AMSAT-NA/PacSatDocs/Test_Data/1_2_V_supply_voltage_noise_and_shift_with_modulation.jpg

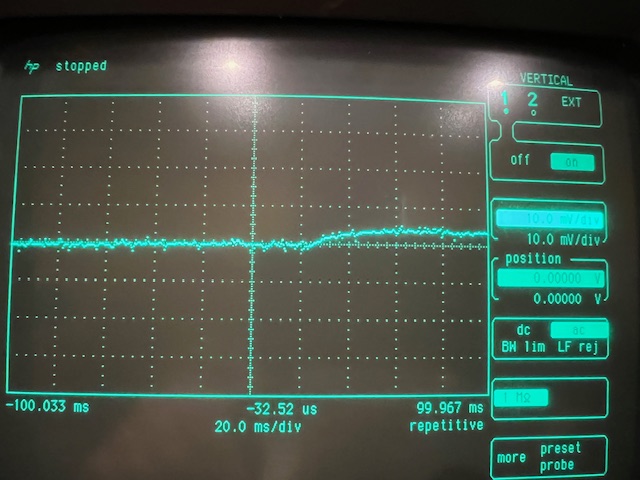
Test_Data/1_2_V_supply_voltage_noise_and_shift_with_modulation.jpg
