AMSAT-NA/PacSatDocs/Test_Data/Port_4_N_with_neg87dB_signal_input.jpg

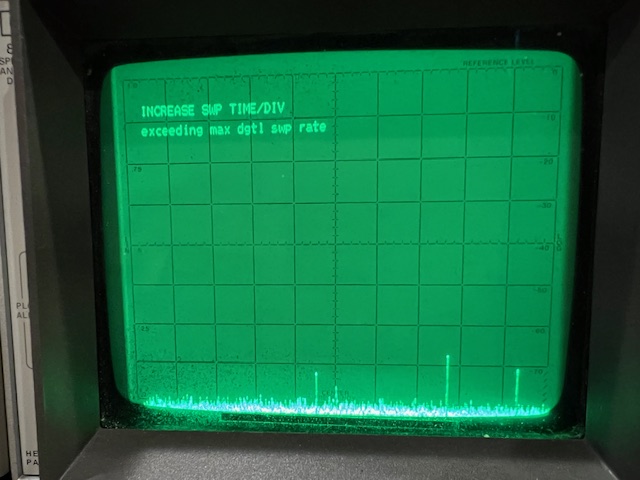
Test_Data/Port_4_N_with_neg87dB_signal_input.jpg
