AMSAT-NA/PacSatDocs/Hardware/Rev_D/PacSat_Dev_RevD_240614/gerbers/README

This directory contains the fabrication outputs necessary 
to get the board etched at a PCB house.
