AMSAT-NA/PacSatDocs/requirements/Pacsat-rtos-software-architecture.odp

PACSAT RTOS Software Architecture

By: Chris Thompson G0KLA, Burns Fisher WB1FJ

Version: 1.02 – 14 Jun 2023

RX Task

Read FIFO data and write PKT to queue

RX PKT Queue

TX Task

For each PKT in queue send preamble and packet

PB PKT Queue

AX25 Task

4x Data Link State Machine

PB Task

PB State Machine

Command

Decode software and hardware commands

Console Task

User interaction for testing

TX PKT Queue

Uplink Task

4x FTL0 State Machines

Telem & Control Task

Periodically collect telemetry and assemble packets

2

RX Event Queue

I-Frame Queue[4]

Reliance Edge File System

Key

AX5043 “FIFO not empty”

AX5043 “FIFO not empty”

BBS

callsign

Uplink Event Queue

2

Data

RTOS Event

AX5043 “FIFO not empty”

AX5043 “FIFO not empty”

4

2

FTL0

Status

RTOS Priority

RTOS Timer

T1 x4

T3 x4

2

Broadcast

callsign

PB

Status

Experiment & Telemetry Data

(WOD)

Experiments

Telemetry Sensors

2

AX5043 “Ready to send”

I2C

SPI

CAN

3

MET Telem Timer


S

2

2
