AMSAT-NA/PacSatDocs/Demo/Pacsat-demo-script-2023-symposium.odt

Symposium demonstration

Setup

The spacecraft is connected to a battery, it has a real time clock. It is powered down.

There are 5 files pre-loaded:

1. WOD file – as though generated on the spacecraft
2. Experiment file 1 – uploaded as though from another spacecraft
3. Experiment file 2 – as though generated on the spacecraft
4. Bulletin message to ALL showing the AMSAT bulletin
5. Message to another station with an image

Before the demo:

- There is sufficient space to upload another short file
- The files are uploaded so that they will not expire on the day of the presentation
- The PB is Open
- The Uplink is Open
- The time is set
- The ground station is open and listening. It contains no directory and has one draft file to upload.
- Dir age should be 99 to make sure we pick up the files.
- No equations – remove any that exist

Demo Procedure

Intro

- Re-cover the purpose of the satellite. A data store designed for delay tolerant connections and able to support on board or uploaded data
- Set the scene by describing a typical ground station and the current state – a satellite with pre-loaded files – WOD telemetry, experiment data, Uploaded from a distant sat, messages from Amateur stations uploaded from the ground.
- Explain why we have a copy of the ground station and how operation differs to a BBS with online connection

Action: The power is connected to the spacecraft and it “comes over the horizon”:

- The PB is seen and the DIR is requested
- Describe the dir contents
- The telemetry is received and should be described box by box on the telemetry tab
- Note the free space is for a small amount of test RAM on the MRAM Disk
- Note the number of files vs what we see in the directory

Action: Download the AMSAT bulletin by setting it P1

- File is received

Action: Setup equation to download PARTNER1 data

- File is received
- Note that we can export the data
- Note that all received packets are sent to the central server so that stations can collaboratively download large files which are re-assembled there and can be shared with experiment partners

Action: Note that data can be sent from other spacecraft but can also be sent by Hams for fun. Reply to the AMSAT bulletin with a comment

- File is uploaded

Action: Press DIR button to refresh the directory

- Uploaded File is visible in dir

Action: Download the image file

- Note that this could be experiment data from an onboard camera or it could be data from another spacecraft. It can also be an image uploaded by a ham for fun
- While downloading explain that we plan future tests at higher speeds, with different formats and automated between two satellites working together.

TO RESET THE TEST

To make resetting the test easier a copy of the ground station contains the files to be uploaded and the callsign of the uploader

- Open the PACSAT_DEMO_SETUP version of the ground station
- Send the Format command to the spacecraft
- Send the Time command to the spacecraft
- Open each of the 5 files in the Outbox and click Send
- When they are uploaded close the PACSAT_DEMO_SETUP version
- Go into PACSAT_DEMO folder and delete the Pacsat dir contents.
- Unplug the spacecraft.
- Open the PACSAT_DEMO version of the spacecraft
- The Demo is ready to run
