AMSAT-NA/PacSatDocs/Hardware/pinouts.ods

Connector Pins Used on PacSat-Dev Board vs. LTM Document
N5BRG 7/13/23
LTM Document |  |  | CubeSpace ADCS |  | PacSat_Dev
Yellow | 1 |  | CANL | 1 | 3.3V
H1 | 2 |  |  | 2
 | 3 |  | CANH | 3
 | 4 |  |  | 4
 | 5 |  |  | 5
 | 6 |  |  | 6
 | 7 |  |  | 7
 | 8 |  |  | 8
 | 9 |  |  | 9 | 3.3V
 | 10 |  |  | 10
 | 11 |  |  | 11
 | 12 |  |  | 12
 | 13 |  |  | 13
 | 14 |  |  | 14 | GIOA_3
 | 15 |  |  | 15 | GIOA_2
 | 16 |  |  | 16 | GIOA_1
 | 17 |  | UART1 | 17 | GIOA_6
 | 18 |  | UART1 | 18
 | 19 |  | UART1 | 19 | FAULT_N
 | 20 | TLM4 | UART1 | 20
 | 21 | TLM3 |  | 21
 | 22 | TLM2 |  | 22
 | 23 | TLM1 |  | 23 | HW_POWER_OFF_N
 | 24 |  |  | 24
 | 25 |  |  | 25
 | 26 |  |  | 26
 | 27 | L1 |  | 27 | CMD_MODE
 | 28 |  |  | 28
 | 29 | I2C1_reset |  | 29
 | 30 |  |  | 30
 | 31 |  |  | 31 | ATTACHED
 | 32 |  |  | 32 | UART_TX2
 | 33 |  | UART2 | 33
 | 34 |  |  | 34
 | 35 |  | UART2 | 35 | VER_BIT1
 | 36 |  |  | 36 | UART_RX2
 | 37 |  |  | 37
 | 38 |  |  | 38
 | 39 | Tx3 | UART2 | 39
 | 40 | Rx3 | UART2 | 40
 | 41 | I2C1_sda | I2c_SDA | 41 | I2C1_sda
 | 42 |  |  | 42
 | 43 | I2C_sck | I2c_SCK | 43 | I2C_sck
 | 44 |  |  | 44
 | 45 |  |  | 45
 | 46 |  |  | 46
 | 47 |  | Sw 5V Options | 47 | VER_BIT0
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
