AMSAT-NA/PacSatDocs/requirements/LaunchPad_Headers.ods

 |  |  |  |  | The common term for the data lines is MISO and MOSI. |  |  | Note: Device highlighted must be selected in Pinmux
 |  |  |  | TI calls them SOMI and SIMO, the MRAMs call them SO and SI.
 |  |  |  | SOC Device 1 | SOC Device 2 | SOC Device 3 | SOC Device 4 | WB1BF Propsed Use | Programming comments | Board Symbols
 |  | J2
 |  |  | 1 | +3.3V |  |  |  | Power |  | +3.3V
 |  |  | 2 | AD1IN[16]/AD2IN[0] | AD2IN[0]
 |  |  | 3 | N2HET1[6] | SCIRX | EPWM5A |  | Console serial line (Rx) |  | SCIRX
 |  |  | 4 | N2HET1[13] | SCITX | EPWM5B |  | Console serial line (Tx) |  | SCITX
 |  |  | 5 | GIOA[7] | N2HET2[6] | EPWM2A
 |  |  | 6 | AD1IN[17] | AD2IN[1]
J11 | 38 |  | 7 | MIBSPI3CLK | AWM_EXT_SEL[1] | EQEP1A |  | CLK For AX5043 chips |  | AX5043_CLK
 |  |  | 8 | GIOA[6] | N2HET2[4] | EPWM1B
 |  |  | 9 | N2HET1[4] | EPWM4B
 |  |  | 10 | N2HET1[9] | N2HET2[16] | EPWM7A
 |  | J3
 |  |  | 1 | +5V In with JP3 |  |  |  |  |  | +5V
 |  |  | 2 | GND |  |  |  | Ground |  | Ground
 |  |  | 3 | AD1N[0]
 |  |  | 4 | AD1N[7]
 |  |  | 5 | AD1N[18] | AD1N[2]
 |  |  | 6 | AD1N[19] | AD1N[3]
 |  |  | 7 | AD1N[20] | AD1N[4]
 |  |  | 8 | AD1N[21] | AD1N[5]
 |  |  | 9 | Unused?
 |  |  | 10 | Unused?
 |  | J4
 |  |  | 1 | N2HET1[20] | /EPWM6B
 |  |  | 2 | N2HET1[18] | EPWM6A
 |  |  | 3 | N2HET1[16]
 |  |  | 4 | N2HET1[30] | MII_RX_DV | EPWM1SYNCI | EQEP2S
 |  |  | 5 | N2HET1[14]
 |  |  | 6 | N2HET1[12] | MII_CRS | RMII_CRS_DV
 |  |  | 7 | GIOA[5] | EXTCLKIN | EPWM1A
 |  |  | 8 | GIOA[2] | N2HET2[0] | EQEP2I
 |  |  | 9 | GIOA[1]
 |  |  | 10 | GIOA[0]
 |  | J5
 |  |  | 1 | GND
 |  |  | 2 | N2HET1[22]
J11 | 30 |  | 3 | MIBSPI3NCS[1] | N2HET1[25] | MDCLK |  | Chip select for AX5043_0 |  | AX5043_VHF_SEL
 |  |  | 4 | GIOB[3] |  |  |  | IRQ for AX5043-1 |  | AX5043_UHF_IRQ
 |  |  | 5 | HERCULES_NRST
J11 | 37 |  | 6 | MIBSPI3SIMO | AWM_EXT_SEL[0] | ECAP3 |  | MOSI for AX5043s |  | AX5043_MOSI
J11 | 36 |  | 7 | MIBSPI3SOMI | AWM_EXT_ENA | ECAP2 |  | MISO for AX5043s |  | AX5043_MISO
 | 9 |  | 8 | MIBSPI3NCS[2] | I2C_SDA | N2HET1[27] | NTZ2 | I2C SDA (if you want a temp chip like the Pi 5043 card has) |  | I2C_SDA
 | 8 |  | 9 | MIBSPI3NCS[3] | I2C_SCL | N2HET1[29] | NTZ1 | I2C SCL (if you want a temp chip like the Pi 5043 card has) |  | I2C_SCL
 |  |  | 10 | GIOB[2]
 |  | J6
 |  |  | 1 | +3.3 V |  |  |  | Power |  | NP
 |  |  | 2 | AD1IN[9] | AD2IN[9]
 |  |  | 3 | HERCULES_LIN1_RXD
 |  |  | 4 | HERCULES_LIN1_TXD
 |  |  | 5 | MIBSPI3NCS[0] | AD2EVT | GIOB[2] | EQEP1I
 |  |  | 6 | AD1IN[1]
J10 | 32 |  | 7 | MIBSPI1CLK |  |  |  | MRAM CLK |  | MRAM_SCK
 |  |  | 8 | MIBSPI3NENA | MIBSPI3NCS[5] | N2HET1[31] | EQEP1B
J10 | 37 |  | 9 | N2HET1[24] | MIBSPI1NCS[5] | MII_RXD[0] | RMII_RXD[0] | MRAM-3 NCS |  | MRAM_3_CS
 |  |  | 10 | N2HET1[26] | MII_RXD[1] | RMII_RXD[1]
 |  | J7
 |  |  | 1 | +5.0 V |  |  |  |  |  | NP
J10 | 34 |  | 2 | GND |  |  |  | Ground |  | Ground
 |  |  | 3 | AD1IN[10] | AD2IN[10]
 |  |  | 4 | AD1IN[2]
 |  |  | 5 | AD1IN[3]
 |  |  | 6 | AD1IN[11] | AD2IN[11]
 |  |  | 7 | AD1IN[4]
 |  |  | 8 | AD1IN[12] | AD2IN[12]
 |  | J8
 |  |  | 1 | N2HET1[10] | MII_TX_CLK | MII_TX_AVCLK4 | NTZ3
 |  |  | 2 | N2HET1[28] | MII_RXCLK | RMII_REFCLK | MII_RX_AVCLK4
 |  |  | 3 | N2HET1[8] | MIBSPI1SIMO[1] | MII_TXD[3]
 |  |  | 4 | MIBSPI1NENA | N2HET1[23] | MII_RXD[2] | ECAP4
 |  |  | 5 | MIBSPI5NENA | MII_RXD[3] | MIBSPI5SOMI[1] | ECAP5
J11 | 11 |  | 6 | N2HET1[11] | MIBSPI3NCS[4] | N2HET2[18] | EPWM1SYNCO | AX5043-1 NCS |  | AX5043_UHF_CS
 |  |  | 7 | GIOB[1]
J10 | 15 |  | 8 | GIOB[0] |  |  |  | AX5043-0 IRQ | Set up interrupt in GIO and Interrupt Tabs | AX5043_VHF_IRQ
 |  |  | 9 | AD1EVT | MII_RX_ER | RMII_RX_ER
 |  |  | 10 | MIBSPI5CLK | MII_TXEN | RMII_TXEN
 |  | J9
 |  |  | 1 | GND
 |  |  | 2 | N2HET1[1] | SPI4NENA | N2HET2[8] | EQEP2A
J10 | 26 |  | 3 | MIBSPI1NCS[0] | MIBSPI1SOMI[1] | MII_TXD[2] | ECAP6 | MRAM-0 NCS |  | MRAM_0_CS
 |  |  | 4 | MIBSPI5SIMO[0] | MII_TXD[1] | RMII_TXD[1] | MIBSPI5SOMI[2]
 |  |  | 5 | HERCULES_NRST
J10 | 35 |  | 6 | MIBSPI1SIMO |  |  |  | MRAM SI |  | MRAM_MOSI
J10 | 33 |  | 7 | MIBSPI1SOMI |  |  |  | MRAM SO |  | MRAM_MISO
J10 | 11 |  | 8 | MIBSPI1NCS[1] | N2HET1[17] | MII_COL | EQEP1S | MRAM-1 NCS |  | MRAM_1_CS
J11 | 31 |  | 9 | MIBSPI1NCS[2] | N2HET1[19] | MDIO |  | MRAM-2 NCS |  | MRAM_2_CS
 |  |  | 10 | MIBSPI5SOMI[0] | MII_TXD[0] | RMII_TXD[0]
