AMSAT-NA/PacSatDocs/Hardware/Rev_D/PacSat_Dev_RevD_240614/PacSat_CPU_Pin_Assignment.ods

Sheet: ROOT LIST CPU Pin
Last Revised | 231117 | RSS
CPU Pin # | Discription | Signal | Connection |  | Pin Use | Voltage | Pullup/Down
1 | GIOB_3 | GIOB_3 | PC104-14 | IO | Bidirectional | ?
2 | GIOA_0 | FCODE_STROBE | PC104-56 | IO | Bidirectional | ?
3 | MIBSPI3NCS_3 | I2C_SCL | U30-2 | Temp Susnor | Output | 3.3V
4 | MIBSPI3NCS_2 | I2C_SDA | U30-1 | Temp Sensor | Bidirectional | 3.3V
5 | GIOA_1 | AX5043_IRQ_RX1 | U205-19 | RX1_IRQ | Input | 3.3V | Add on chip pullup
6 | N2HET_11 | HW_Sense | Pull Up | Not USED | Input | ?
7 | FLTP1 | No Connection |  |  | Not USED
8 | FLTP2 | No Connection |  |  | Not USED
9 | GIOA_2 | GIOA_2 | PC104-14 | IO | Bidirectional | ?
10 | VCCIO | +3.3VDC |  |  | PWR | 3.3V
11 | VSS | GND Plane |  |  | GND
12 | CAN3RX | No Connection |  |  | Not USED
13 | CAN3TX | HW_POWER_OFF_N | PC104-23 | IO | Input | ?
14 | GIOA_5 | AX5043_IRQ_RX4 | U505-19 | RX4_IRQ | Input | ? | Add on chip pullup
15 | N2HET1_22 | ALERT_SIGNAL | PC104-49 | IO | Input | ?
16 | GIOA_6 | GIOA_6 | PC104-17 | IO | Bidirectional | ?
17 | VCC | +1.2 VDC |  |  | PWR | 1.2V
18 | OSCN | Clock5 |  |  | CLK | 3.3V
19 | Kelvin GNS | GND Plane |  |  | GND
20 | OSCOUT | No Connection |  |  | No Connection
21 | VSS | GND Plane |  |  | GND
22 | GIOA_7 | AX5043_IRQ_RX3 | U405-19 | RX3_IRQ | Input | 3.3V | Add on chip pullup
23 | N2HET1_1 | LED D3 YEL | D3-1 |  | Output | 3.3V
24 | N2HET1_3 | AX5043_SEL1 | U205-14 | RX1_SEL | Output | 3.3V
25 | N2HET1_0 | LED D2 RED | D2-1 | LED RED | Output | 3.3V
26 | VCCIO | +3.3 VDC |  |  | PWR | 3.3V
27 | VSS | GND Plane |  |  | GND
28 | VSS | GND Plane |  |  | GND
29 | VCC | +1.2 VDC |  |  | PWR | 1.2V
30 | N2HET1_2 | LED D4 GRN | D4-1 | LED-GRN | Output | 3.3V
31 | N2HET1_5 | REG_5V_EN | U86-2 | +5V Enable | Output | 3.3V
32 | MIBSPI5NCS_0 | MRAM_NCS3 | U79-1 |  | Output | 3.3V
33 | N2HET1_7 | AX5043_SEL2 | U305-1 | RX2 Select | Output | 3.3V
34 | TEST | GND Plane |  |  | GND
35 | N2HET1_9 | AX5043_SEL3 | U405-14 | RX3 SEL | Output | 3.3V
36 | N2HET1_4 | AX5042_SEL4 | U505-14 | RX4 SEL | Output | 3.3V
37 | MIBSP13NCS_1 | No Connection |  |  | No Connection
38 | N2HET1_6/SCIRX | UART_RX1 | PC104-92 | USB RX | Input | 3.3V
39 | N2HET1_13/SCITX | UART_TX1 | PC104-88 | USB TX | Output | 3.3V
40 | MIBSPI1NCS_2 | MRAM_NCS2 | U77-1 | MRAM CS | Output | 3.3V
41 | N2HET1_15 | FCODE_D0 | PC104-64 |  | Input | ?
42 | VCCIO | +3.3 VDC |  |  | PWR | 3.3V
43 | VSS | GND Plane |  |  | GND
44 | VSS | GND Plane |  |  | GND
45 | VCC | +1.2VDC |  |  | PWR | 1.2V
46 | nPORRST | Pull Up 3.3K Ohm |  |  | Input | 3.3V
47 | VSS | GND Plane |  |  | GND
48 | VCC | +1.2VDC |  |  | PWR | 1.2V
49 | VCC | +1.2VDC |  |  | PWR | 1.2V
50 | VSS | GND Plane |  |  | GND
51 | MIBSPI3SOMI | AX5043_MISO | U205-16,U156-16,U405-16,J801-6,U505-16 | AX5043 MISO | Input | 3.3V
52 | MIBSPI3SOMO | AX5043_MOSI | U205-17,U156-17,U405-17,J801-4,U505-17 | AX5043 MOSI | Output | 3.3V
53 | MIBSPI3CLK | AX5043_CLK | U205-15,U156-15,U405-15,J801-8,U505-15 | AX5043 CLK | CLK | 3.3V
54 | MIBSPI3NENA | No Connection |  |  | No Connection
55 | MIBSPI3NCS_0 | MRAM_NCS1 | U78-1 | MRAM CS | Output | 3.3V
56 | VSS | GND Plane |  |  | GND
57 | VCC | +1.2VDC |  |  | PWR | 1.2V
58 | AD1IN16 | No Connection |  |  | No Connection
59 | AD1IN17 | No Connection |  |  | No Connection
60 | AD1IN_0 | No Connection |  |  | No Connection
61 | AD1IN_7 | PWR_FLAG_AX5043 | U93-6 | AX5043 3.3V Supply | Input A/D | 3.3V
62 | AD1IN_18 | No Connection |  |  | No Connection
63 | AD1IN_19 | No Connection |  |  | No Connection
64 | AD1IN_20 | VER_BIT0 | Resistor |  | Input | 3.3V
65 | AD1IN_21 | VER_BIT1 | Resistor |  | Input | 3.3V
66 | ADREFHI | +3.3VDC |  |  | PWR | 3.3V
67 | ADREFLO | GND Plane |  |  | GND
68 | VSSAD | GND Plane |  |  | GND
69 | VCCAD | +3.3VDC |  |  | PWR | 3.3V
70 | AD1IN_9 | No Connection |  |  | No Connection
71 | AD1IN_1 | No Connection |  |  | No Connection
72 | AD1IN_10 | No Connection |  |  | No Connection
73 | AD1IN_2 | Current_Fault_U89 | NOT USED? |  | No Connection
74 | AD1IN_3 | Current_Fault_U89 | NOT USED? |  | No Connection
75 | AD1IN_11 | No Connection |  |  | No Connection
76 | AD1IN_4 | PWR_FLAG_SSPA | U94-6 | SSPA | Input | 3.3V
77 | AD1IN_12 | A/D 12 | R119,R117 | +5VDC A/D Inpit | Input A/D | 2.5V
78 | AD1IN_5 | PWR_SW_SSPA | U94-4 | SSPA Enable | Output | 3.3V
79 | AD1IN_13 | A/D 13 | R118 | +1.2VDC A/D Inpit | Input A/D | 1.2V
80 | AD1IN_6 | A/D 6 | R114,R115 | +3.3VDC A/D Inpit | Input A/D | 3.3V
81 | AD1IN_22 | No Connection |  |  | No Connection
82 | AD1IN_14 | VER_BIT2 | Resistor |  | Input | 3.3V
83 | AD1IN_8 | No Connection |  |  | No Connection
84 | AD1IN_23 | No Connection |  |  | No Connection
85 | AD1IN_15 | VER_BIT3 | Resistor |  | Input | 3.3V
86 | AD1EVT | No Connection |  |  | No Connection
87 | VCC | +1.2VDC |  |  | PWR | 1.2V
88 | VSS | GND Plane |  |  | GND
89 | CAN1TX | No Connection |  |  | No Connection
90 | CAN1RX | No Connection |  |  | No Connection
91 | N2HET1_24 | UART_CTS (DTE) | PC104-100 | USB CTS | Input | 3.3V
92 | N2HET1_26 | UART_RTS (DTE) | PC104-96 | USB RTS | Output | 3.3V
93 | MIBSP1SMO | MRAM_MOSI | U76-5 | MRAM SI | Output | 3.3V
94 | MIBSP1SMI | MRAM_MISO | U76-6, U77-6, U78-6, U79 -6 | MRAM SO | Input | 3.3V
95 | MIBSPI1CLK | MRAM_CLK | U76-1, U77-1, U78-1, U79 -1 | MRAM SCK | CLK Output | 3.3V
96 | MIBSP11NENA | No Connection |  |  | No Connection
97 | MIBSP15NENA | No Connection |  |  | No Connection
98 | MIBSP15SOMI_0 | No Connection |  |  | No Connection
99 | MIBSP15SIMO_0 | No Connection |  |  | No Connection
100 | MIBSPI5CLK | No Connection |  |  | No Connection
101 | VCC | +1.2VDC |  |  | PWR | 1.2V
102 | VSS | GND Plane |  |  | GND
103 | VSS | GND Plane |  |  | GND
104 | VCCIO | +3.3VDC |  |  | PWR | 3.3V
105 | MIBSPI1NCS_0 | MRAM_NCS0 | U76-1 | MRAM 0 CS | Output | 3.3V
106 | N2HET1_8 | ATTACHED | PC104-31 |  | Input | ?
107 | N2HET1_28 | PB_ENABLE | PC104-49 |  | Input | ?
108 | TMS | JTAG_TMS | J2-2 |  | Input | 3.3V
109 | nTRST | Pull Up 3.3K Ohm |  |  | Input | 3.3V
110 | TDI | JTAG_TDI | J2-8 |  | Input | 3.3V
111 | TDO | JTAG_TDO | J2-6 |  | Output | 3.3V
112 | TCK | JTAG_TCK | J2-4 |  | Input CLK | 3.3V
113 | RTCK | JTAG_RTCK | J2-7 |  | Input CLK | 3.3V
114 | VCC | +1.2VDC |  |  | PWR | 1.2V
115 | VSS | GND Plane |  |  | GND
116 | nRST | Pull Up 3.3K Ohm |  |  | Input | 3.3V
117 | nERROR | FAULT_N | PC104-19 |  | Input | ?
118 | N2HET1_10 | Alarm XMIT Shutdown | U28-5, U89-3 |  | Output | 3.3V | Ral Time Clock INTA_N, Turns off Power to Transmit
119 | ECLK | No Connection |  |  | No Connection
120 | VCCIO | +3.3VDC |  |  | PWR | 3.3V
121 | VSS | GND Plane |  |  | GND
122 | VSS | GND Plane |  |  | GND
123 | VCC | +1.2VDC |  |  | PWR | 1.2V
124 | N2HET1_12 | AX5043_SEL_TX | U156-14 | AX5043 TX SEL | Output | 3.3V
125 | N2HET1_14 | ONEWIRE | U26-2 | Secure Byte IO | Bidirectional | 3.3V
126 | GOIB_0 | AX5043_IRQ_RX2 | U305-19 | RX2 IRQ | Input | 3.3V | Add on chip pullup
127 | N2HET1_30 | CMD_MODE | PC104-27 |  | Input | 3.3V
128 | CAN2TX | No Connection |  |  | No Connection
129 | CAN2RX | No Connection |  |  | No Connection
130 | MIBSP1NCS_1 | FEED_WATCHDOG | U90-4, U95-4 | Keep Watchdog happy | Output | 3.3V
131 | LINRX | UART_RX2 | PC104-36 | UART RX2 | Input | 3.3V
132 | LINTX | UART_TX2 | PC104-32 | UART TX2 | Output | 3.3V
133 | GIOB_1 | GOIB_1 | PC104-16 | IO Bit | Bidirectional | ?
134 | VCCP | +3.3VDC |  |  | PWR | 3.3V
135 | VSS | GND Plane |  |  | GND
136 | VCCIO | +3.3VDC |  |  | PWR | 3.3V
137 | VCC | +1.2VDC |  |  | PWR | 1.2V
138 | VSS | GND Plane |  |  | GND
139 | N2HET1_16 | FCODE_D3 | PC104-60 |  | Input | ?
140 | N2HET1_18 | USB_Suspend_Low | PC104-104 | USB Control | Input | 3.3V
141 | N2HET1_20 | No Connection |  |  | No Connection
142 | GIOB_2 | AX5043_IRQ_TX | U156-19 | AX5043 TX IRQ | Input | 3.3V | Add on chip pullup
143 | VCC | +1.2VDC |  |  | PWR | 1.2V
144 | VSS | GND Plane |  |  | GND

Sheet: Sort By Connection Point
29 | VCC | +1.2 VDC |  |  | KEY:
17 | VCC | +1.2 VDC |  |  |  | Configured in HCG for PACSAT
45 | VCC | +1.2VDC |  |  |  | Left as default in HCG
48 | VCC | +1.2VDC |  |  |  | Problem Configuring Pin
49 | VCC | +1.2VDC
57 | VCC | +1.2VDC
101 | VCC | +1.2VDC
114 | VCC | +1.2VDC
123 | VCC | +1.2VDC
137 | VCC | +1.2VDC
143 | VCC | +1.2VDC
87 | VCC | +1.2VDC
26 | VCCIO | +3.3 VDC
42 | VCCIO | +3.3 VDC
66 | ADREFHI | +3.3VDC
69 | VCCAD | +3.3VDC
104 | VCCIO | +3.3VDC
120 | VCCIO | +3.3VDC
134 | VCCP | +3.3VDC
136 | VCCIO | +3.3VDC
10 | VCCIO | +3.3VDC
77 | AD1IN_12 | A/D 12
79 | AD1IN_13 | A/D 13
80 | AD1IN_6 | A/D 6
118 | N2HET1_10 | Alarm XMIT Shutdown | U28-5, U89-3 | 0
15 | N2HET1_22 | ALERT_SIGNAL | PC104-49 | IO
106 | N2HET1_8 | ATTACHED | PC104-31
36 | N2HET1_4 | AX5042_SEL4 | U505-14 | RX4 SEL
53 | MIBSPI3CLK | AX5043_CLK | U205-15,U156-15,U405-15,J801-8,U505-15 | AX5043 CLK
5 | GIOA_1 | AX5043_IRQ_RX1 | U205-19 | RX1_IRQ
126 | GOIB_0 | AX5043_IRQ_RX2 | U305-19 | RX2 IRQ
22 | GIOA_7 | AX5043_IRQ_RX3 | U405-19 | RX3_IRQ
14 | GIOA_5 | AX5043_IRQ_RX4 | U505-19 | RX4_IRQ
142 | GIOB_2 | AX5043_IRQ_TX | U156-19 | AX5043 TX IRQ
51 | MIBSPI3SOMI | AX5043_MISO | U205-16,U156-16,U405-16,J801-6,U505-16 | AX5043 MISO
52 | MIBSPI3SOMO | AX5043_MOSI | U205-17,U156-17,U405-17,J801-4,U505-17 | AX5043 MOSI
124 | N2HET1_12 | AX5043_SEL_TX | U156-14 | AX5043 TX SEL
24 | N2HET1_3 | AX5043_SEL1 | U205-14 | RX1_SEL
33 | N2HET1_7 | AX5043_SEL2 | U305-1 | RX2 Select
35 | N2HET1_9 | AX5043_SEL3 | U405-14 | RX3 SEL
18 | OSCN | Clock5 | U653-9 | CPU Clock 16 MHz
127 | N2HET1_30 | CMD_MODE | PC104-27
73 | AD1IN_2 | Current_Fault_U89 | NOT USED?
74 | AD1IN_3 | Current_Fault_U89 | NOT USED?
117 | nERROR | FAULT_N | PC104-19
41 | N2HET1_15 | FCODE_D0 | PC104-64
139 | N2HET1_16 | FCODE_D3 | PC104-60
2 | GIOA_0 | FCODE_STROBE | PC104-56 | IO
130 | MIBSP1NCS_1 | FEED_WATCHDOG | U90-4, U95-4 | Keep Watchdog happy
9 | GIOA_2 | GIOA_2 | PC104-14 | IO
16 | GIOA_6 | GIOA_6 | PC104-17 | IO
1 | GIOB_3 | GIOB_3 | PC104-14 | IO
88 | VSS | GND Plane
11 | VSS | GND Plane
19 | Kelvin GNS | GND Plane
21 | VSS | GND Plane
27 | VSS | GND Plane
28 | VSS | GND Plane
34 | TEST | GND Plane
43 | VSS | GND Plane
44 | VSS | GND Plane
47 | VSS | GND Plane
50 | VSS | GND Plane
56 | VSS | GND Plane
67 | ADREFLO | GND Plane
68 | VSSAD | GND Plane
102 | VSS | GND Plane
103 | VSS | GND Plane
115 | VSS | GND Plane
121 | VSS | GND Plane
122 | VSS | GND Plane
135 | VSS | GND Plane
138 | VSS | GND Plane
144 | VSS | GND Plane
144 | VSS | GND Plane
133 | GIOB_1 | GOIB_1 | PC104-16 | IO Bit
13 | CAN3TX | HW_POWER_OFF_N | PC104-23 | IO
6 | N2HET_11 | HW_Sense | Pull Up | Not USED
3 | MIBSPI3NCS_3 | I2C_SCL | U30-2 | Temp Susnor
4 | MIBSPI3NCS_2 | I2C_SDA | U30-1 | Temp Sensor
113 | RTCK | JTAG_RTCK | J2-7
112 | TCK | JTAG_TCK | J2-4
110 | TDI | JTAG_TDI | J2-8
111 | TDO | JTAG_TDO | J2-6
108 | TMS | JTAG_TMS | J2-2
25 | N2HET1_0 | LED D2 RED | D2-1 | LED RED
23 | N2HET1_1 | LED D3 YEL | D3-1
30 | N2HET1_2 | LED D4 GRN | D4-1 | LED-GRN
94 | MIBSP1SMI | MRAM_MISO | U76-6, U77-6, U78-6, U79 -6 | MRAM SO
93 | MIBSP1SMO | MRAM_MOSI | U76-5 | MRAM SI
105 | MIBSPI1NCS_0 | MRAM_NCS0 | U76-1 | MRAM 0 CS
55 | MIBSPI3NCS_0 | MRAM_NCS1 | U78-1 | MRAM CS
40 | MIBSPI1NCS_2 | MRAM_NCS2 | U77-1 | MRAM CS
32 | MIBSPI5NCS_0 | MRAM_NCS3 | U79-1
89 | CAN1TX | No Connection
95 | MIBSPI1CLK | MRAM_CLK | U76-1, U77-1, U78-1, U79 -1 | MRAM SCK
7 | FLTP1 | No Connection
8 | FLTP2 | No Connection
12 | CAN3RX | No Connection
20 | OSCOUT | No Connection
37 | MIBSP13NCS_1 | No Connection
54 | MIBSPI3NENA | No Connection
58 | AD1IN16 | No Connection
59 | AD1IN17 | No Connection
60 | AD1IN_0 | No Connection
62 | AD1IN_18 | No Connection
63 | AD1IN_19 | No Connection
70 | AD1IN_9 | No Connection
71 | AD1IN_1 | No Connection
72 | AD1IN_10 | No Connection
75 | AD1IN_11 | No Connection
81 | AD1IN_22 | No Connection
84 | AD1IN_23 | No Connection
90 | CAN1RX | No Connection
96 | MIBSP11NENA | No Connection
97 | MIBSP15NENA | No Connection
98 | MIBSP15SOMI_0 | No Connection
99 | MIBSP15SIMO_0 | No Connection
100 | MIBSPI5CLK | No Connection
119 | ECLK | No Connection
128 | CAN2TX | No Connection
129 | CAN2RX | No Connection
141 | N2HET1_20 | No Connection
83 | AD1IN_8 | No Connection
86 | AD1EVT | No Connection
125 | N2HET1_14 | ONEWIRE | U26-2 | Secure Byte IO
107 | N2HET1_28 | PB_ENABLE | PC104-49
46 | nPORRST | Pull Up 3.3K Ohm
109 | nTRST | Pull Up 3.3K Ohm
116 | nRST | Pull Up 3.3K Ohm
61 | AD1IN_7 | PWR_FLAG_AX5043 | U93-6 | AX5043 3.3V Supply
76 | AD1IN_4 | PWR_FLAG_SSPA | U94-6 | SSPA
78 | AD1IN_5 | PWR_SW_SSPA | U94-4 | SSPA Enable
31 | N2HET1_5 | REG_5V_EN | U86-2 | +5V Enable
91 | N2HET1_24 | UART_CTS (DTE)
92 | N2HET1_26 | UART_RTS (DTE) | PC104-96 | USB RTS
38 | N2HET1_6/SCIRX | UART_RX1 | PC104-92 | USB RX
131 | LINRX | UART_RX2 | PC104-36 | UART RX2
39 | N2HET1_13/SCITX | UART_TX1 | PC104-88 | USB TX
132 | LINTX | UART_TX2 | PC104-32 | UART TX2
140 | N2HET1_18 | USB_Suspend_Low | PC104-104 | USB Control
64 | AD1IN_20 | VER_BIT0 | Resistor
65 | AD1IN_21 | VER_BIT1 | Resistor
82 | AD1IN_14 | VER_BIT2 | Resistor
85 | AD1IN_15 | VER_BIT3

Sheet: Sort By Function
#REF! | CPU Pin # | Discription | Signal | Connection
#REF! | 25 | N2HET1_0 | LED D2 RED | D2-1 |  | LED RED
#REF! | 23 | N2HET1_1 | LED D3 YEL | D3-1
#REF! | 30 | N2HET1_2 | LED D4 GRN | D4-1 |  | LED-GRN
#REF! | 108 | TMS | JTAG_TMS | J2-2
#REF! | 112 | TCK | JTAG_TCK | J2-4
#REF! | 111 | TDO | JTAG_TDO | J2-6
#REF! | 113 | RTCK | JTAG_RTCK | J2-7
#REF! | 110 | TDI | JTAG_TDI | J2-8
#REF! | 73 | AD1IN_2 | Current_Fault_U89 | NOT USED?
#REF! | 74 | AD1IN_3 | Current_Fault_U89 | NOT USED?
#REF! | 91 | N2HET1_24 | UART_CTS (DTE) | PC104-100 | #REF! | USB CTS
#REF! | 140 | N2HET1_18 | USB_Suspend_Low | PC104-104 |  | USB Control
#REF! | 1 | GIOB_3 | GIOB_3 | PC104-14 |  | IO
#REF! | 9 | GIOA_2 | GIOA_2 | PC104-14 |  | IO
#REF! | 133 | GIOB_1 | GOIB_1 | PC104-16 |  | IO Bit
#REF! | 16 | GIOA_6 | GIOA_6 | PC104-17 |  | IO
#REF! | 117 | nERROR | FAULT_N | PC104-19
#REF! | 13 | CAN3TX | HW_POWER_OFF_N | PC104-23 |  | IO
#REF! | 127 | N2HET1_30 | CMD_MODE | PC104-27
#REF! | 106 | N2HET1_8 | ATTACHED | PC104-31
#REF! | 132 | LINTX | UART_TX2 | PC104-32 |  | UART TX2
#REF! | 131 | LINRX | UART_RX2 | PC104-36 |  | UART RX2
#REF! | 15 | N2HET1_22 | ALERT_SIGNAL | PC104-49 |  | IO
#REF! | 107 | N2HET1_28 | PB_ENABLE | PC104-49
#REF! | 2 | GIOA_0 | FCODE_STROBE | PC104-56 |  | IO
#REF! | 139 | N2HET1_16 | FCODE_D3 | PC104-60
#REF! | 41 | N2HET1_15 | FCODE_D0 | PC104-64
#REF! | 39 | N2HET1_13/SCITX | UART_TX1 | PC104-88 |  | USB TX
#REF! | 38 | N2HET1_6/SCIRX | UART_RX1 | PC104-92 |  | USB RX
#REF! | 92 | N2HET1_26 | UART_RTS (DTE) | PC104-96 | #REF! | USB RTS
#REF! | 6 | N2HET_11 | HW_Sense | Pull Up |  | Not USED
#REF! | 80 | AD1IN_6 | A/D 6 | R114,R115 |  | +3.3VDC A/D Inpit
#REF! | 79 | AD1IN_13 | A/D 13 | R118 |  | +1.2VDC A/D Inpit
#REF! | 77 | AD1IN_12 | A/D 12 | R119,R117 |  | +5VDC A/D Inpit
#REF! | 64 | AD1IN_20 | VER_BIT0 | Resistor
#REF! | 65 | AD1IN_21 | VER_BIT1 | Resistor
#REF! | 82 | AD1IN_14 | VER_BIT2 | Resistor
#REF! | 85 | AD1IN_15 | VER_BIT3 | Resistor
#REF! | 124 | N2HET1_12 | AX5043_SEL_TX | U156-14 |  | AX5043 TX SEL
#REF! | 142 | GIOB_2 | AX5043_IRQ_TX | U156-19 |  | AX5043 TX IRQ
#REF! | 24 | N2HET1_3 | AX5043_SEL1 | U205-14 |  | RX1_SEL
#REF! | 53 | MIBSPI3CLK | AX5043_CLK | U205-15,U156-15,U405-15,J801-8,U505-15 | #REF! | AX5043 CLK
#REF! | 51 | MIBSPI3SOMI | AX5043_MISO | U205-16,U156-16,U405-16,J801-6,U505-16 | #REF! | AX5043 MISO
#REF! | 52 | MIBSPI3SOMO | AX5043_MOSI | U205-17,U156-17,U405-17,J801-4,U505-17 | #REF! | AX5043 MOSI
#REF! | 5 | GIOA_1 | AX5043_IRQ_RX1 | U205-19 |  | RX1_IRQ
#REF! | 125 | N2HET1_14 | ONEWIRE | U26-2 |  | Secure Byte IO
#REF! | 118 | N2HET1_10 | Alarm XMIT Shutdown | U28-5, U89-3 | #REF! | 0
#REF! | 4 | MIBSPI3NCS_2 | I2C_SDA | U30-1 |  | Temp Sensor
#REF! | 3 | MIBSPI3NCS_3 | I2C_SCL | U30-2 |  | Temp Susnor
#REF! | 33 | N2HET1_7 | AX5043_SEL2 | U305-1 |  | RX2 Select
#REF! | 126 | GOIB_0 | AX5043_IRQ_RX2 | U305-19 |  | RX2 IRQ
#REF! | 35 | N2HET1_9 | AX5043_SEL3 | U405-14 | #REF! | RX3 SEL
#REF! | 22 | GIOA_7 | AX5043_IRQ_RX3 | U405-19 |  | RX3_IRQ
#REF! | 36 | N2HET1_4 | AX5042_SEL4 | U505-14 | #REF! | RX4 SEL
#REF! | 14 | GIOA_5 | AX5043_IRQ_RX4 | U505-19 |  | RX4_IRQ
#REF! | 105 | MIBSPI1NCS_0 | MRAM_NCS0 | U76-1 |  | MRAM 0 CS
#REF! | 93 | MIBSP1SMO | MRAM_MOSI | U76-5 | #REF! | MRAM SI
#REF! | 94 | MIBSP1SMI | MRAM_MISO | U76-6, U77-6, U78-6, U79 -6 | #REF! | MRAM SO
#REF! | 40 | MIBSPI1NCS_2 | MRAM_NCS2 | U77-1 |  | MRAM CS
#REF! | 55 | MIBSPI3NCS_0 | MRAM_NCS1 | U78-1 | #REF! | MRAM CS
#REF! | 32 | MIBSPI5NCS_0 | MRAM_NCS3 | U79-1
#REF! | 31 | N2HET1_5 | REG_5V_EN | U86-2 |  | +5V Enable
#REF! | 130 | MIBSP1NCS_1 | FEED_WATCHDOG | U90-4, U95-4 |  | Keep Watchdog happy
#REF! | 61 | AD1IN_7 | PWR_FLAG_AX5043 | U93-6 | #REF! | AX5043 3.3V Supply
#REF! | 78 | AD1IN_5 | PWR_SW_SSPA | U94-4 |  | SSPA Enable
#REF! | 76 | AD1IN_4 | PWR_FLAG_SSPA | U94-6 |  | SSPA
#REF! | 7 | FLTP1 | No Connection
#REF! | 8 | FLTP2 | No Connection
#REF! | 10 | VCCIO | +3.3VDC
#REF! | 11 | VSS | GND Plane
#REF! | 12 | CAN3RX | No Connection
#REF! | 17 | VCC | +1.2 VDC
#REF! | 18 | OSCN | Clock5
#REF! | 19 | Kelvin GNS | GND Plane
#REF! | 20 | OSCOUT | No Connection
#REF! | 21 | VSS | GND Plane
#REF! | 26 | VCCIO | +3.3 VDC
#REF! | 27 | VSS | GND Plane
#REF! | 28 | VSS | GND Plane
#REF! | 29 | VCC | +1.2 VDC
#REF! | 34 | TEST | GND Plane
#REF! | 37 | MIBSP13NCS_1 | No Connection
#REF! | 42 | VCCIO | +3.3 VDC
#REF! | 43 | VSS | GND Plane
#REF! | 44 | VSS | GND Plane
#REF! | 45 | VCC | +1.2VDC
#REF! | 46 | nPORRST | Pull Up 3.3K Ohm
#REF! | 47 | VSS | GND Plane
#REF! | 48 | VCC | +1.2VDC
#REF! | 49 | VCC | +1.2VDC
#REF! | 50 | VSS | GND Plane
#REF! | 54 | MIBSPI3NENA | No Connection
#REF! | 56 | VSS | GND Plane
#REF! | 57 | VCC | +1.2VDC
#REF! | 58 | AD1IN16 | No Connection
#REF! | 59 | AD1IN17 | No Connection
#REF! | 60 | AD1IN_0 | No Connection
#REF! | 62 | AD1IN_18 | No Connection
#REF! | 63 | AD1IN_19 | No Connection
#REF! | 66 | ADREFHI | +3.3VDC
#REF! | 67 | ADREFLO | GND Plane
#REF! | 68 | VSSAD | GND Plane
#REF! | 69 | VCCAD | +3.3VDC
#REF! | 70 | AD1IN_9 | No Connection
#REF! | 71 | AD1IN_1 | No Connection
#REF! | 72 | AD1IN_10 | No Connection
#REF! | 75 | AD1IN_11 | No Connection
#REF! | 81 | AD1IN_22 | No Connection
#REF! | 83 | AD1IN_8 | No Connection
#REF! | 84 | AD1IN_23 | No Connection
#REF! | 86 | AD1EVT | No Connection
#REF! | 87 | VCC | +1.2VDC
#REF! | 88 | VSS | GND Plane
#REF! | 89 | CAN1TX | No Connection
#REF! | 90 | CAN1RX | No Connection
#REF! | 95 | MIBSPI1CLK | MRAM_CLK
#REF! | 96 | MIBSP11NENA | No Connection
#REF! | 97 | MIBSP15NENA | No Connection
#REF! | 98 | MIBSP15SOMI_0 | No Connection
#REF! | 99 | MIBSP15SIMO_0 | No Connection
#REF! | 100 | MIBSPI5CLK | No Connection
#REF! | 101 | VCC | +1.2VDC
#REF! | 102 | VSS | GND Plane
#REF! | 103 | VSS | GND Plane
#REF! | 104 | VCCIO | +3.3VDC
#REF! | 109 | nTRST | Pull Up 3.3K Ohm
#REF! | 114 | VCC | +1.2VDC
#REF! | 115 | VSS | GND Plane
#REF! | 116 | nRST | Pull Up 3.3K Ohm
#REF! | 119 | ECLK | No Connection
#REF! | 120 | VCCIO | +3.3VDC
#REF! | 121 | VSS | GND Plane
#REF! | 122 | VSS | GND Plane
#REF! | 123 | VCC | +1.2VDC
#REF! | 128 | CAN2TX | No Connection
#REF! | 129 | CAN2RX | No Connection
#REF! | 134 | VCCP | +3.3VDC
#REF! | 135 | VSS | GND Plane
#REF! | 136 | VCCIO | +3.3VDC
#REF! | 137 | VCC | +1.2VDC
#REF! | 138 | VSS | GND Plane
#REF! | 141 | N2HET1_20 | No Connection
#REF! | 143 | VCC | +1.2VDC
#REF! | 144 | VSS | GND Plane
