AMSAT-NA/PacSatDocs/requirements/pacsat-memory-model.ods

Assumptions | Normal |  | Lite |  | How a potential “lite" Pacsat Header is calculated
FILES
Pacsat Header Min | 200 |  | 52 |  | Remove 4 dates, restrict callsigns to 14 bytes, saving 40 bytes
Pacsat Header Max | 300 |  | 125 |  | Limit title, keywords and filenames
Avg Pacsat Header | 250 |  | 88.5 |  |  | MAX | MIN
 |  |  |  |  | Start Bytes | 0 | 0 | If we want these they could be added automatically to the downlink when file is broadcast, but it would complicate checksums etc
Avg Body Size | 232 |  | 232 | '(based on 500 ascii chars compressed) | File Id | 2 | 2
Avg File Size | 482 |  | 320.5 |  | FileSize | 4 | 4
Avg Image Size | 45000 |  | 45000 | '(set max file size to limit e.g. to 60k) | Type | 1 | 1
Avg size of Replies with inc message | 626.6 |  | 352.55 | (assumed reply-inc constrained in lite version) | bodyCRC | 0 | 0 | We omit the CRCs and reply on the MRAM and FEC
 |  |  |  |  | HeaderCRC | 0 | 0
Active stations globally | 30 |  | 30 |  | bodyOffset | 1 | 1 | We limit to one byte and guarantee the header is less than 256 bytes
 |  |  |  |  | uploadTime | 4 | 4
New files per active user each day | 1 |  | 1
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
