AMSAT-NA/PacSatDocs/Hardware/Rev_D/PacSat_Dev_RevD_240614/PacSat_Dev_RevC_231018_Back.jpg

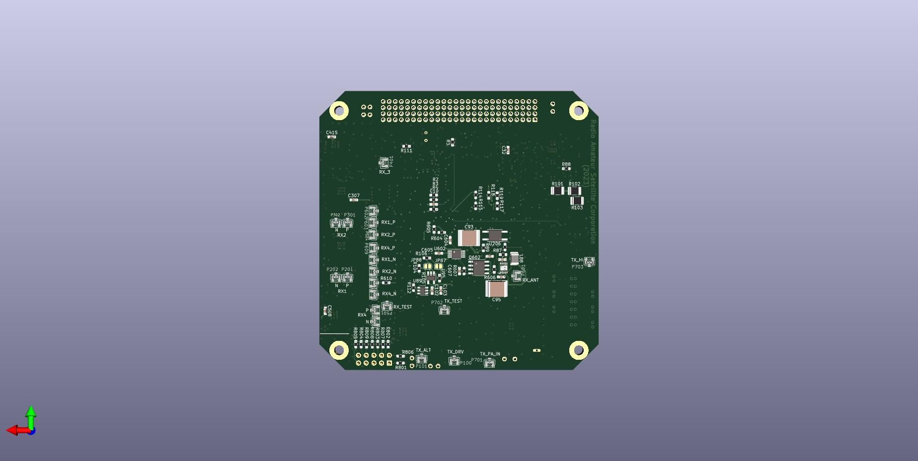
Hardware/Rev_D/PacSat_Dev_RevD_240614/PacSat_Dev_RevC_231018_Back.jpg
