AMSAT-NA/PacSatDocs/TelemDefinition/DownlinkSpecPacsat.xlsx

Sheet: DownlinkSpecPacsat
// | This is the master copy of the downlink structures. A program called FoxStruct.py will turn this into a structure for the flight software.
// | A different Python script can also be used to make tables for FoxTelem. My intent is that this spreadsheet can also be included
// | into a formal document defining the downlink more completely.
// | The format must be as follows: 1) A comment (// in column A) can appear anywhere. 2) A structure must start with a column A that has
// | "Structure:name,file:filename". The structure must end with "END". For flight software, the yellow highlighted columns are used.
Version: 1.0 |  | 2020-12-08
Structure: header_t, file:headerDownlink.h
// | Field Name | Code Name | Size (Bits) | Type | C Type | Conversion | Label | Description | Bit Offset | Byte Offset | Short Offset | Long offset | Module | Module_num | Module_Line | Line_Type
 | uptime | uptime | 32 | Unsigned |  | 0 | Sec | This is the IHU uptime in seconds since the last reset | 0 | 0 | 0 | 0 | NONE | 0 | 0 | 0
 | resetCnt | resetCnt | 16 | Unsigned |  | 0 | Resets | Total number of times IHU has reset since initial on-orbit startup | 32 | 4 | 2 | 1 | NONE | 0 | 0 | 0
 | Downlink Spec Version | protocolVersion | 8 | Unsigned |  | 0 | - | LS4Bits = minor & MS3bits=major | 48 | 6 | 3 | 1.5 | NONE | 0 | 0 | 0
 | Software Major Version | versionMajor | 8 | Unsigned |  | 0 | - | None | 56 | 7 | 3.5 | 1.75 | NONE | 0 | 0 | 0
 | Sofwtare Minor Version | versionMinor | 8 | Unsigned |  | 0 | - | None | 64 | 8 | 4 | 2 | NONE | 0 | 0 | 0
 | Spacecraft Mode | spacecraftMode | 8 | Unsigned |  | 10 | - | The spacecraft mode e.g. SAFE MODE | 72 | 9 | 4.5 | 2.25 | Telem & Control | 1 | 1 | 0
END |  |  |  |  |  |  |  | Total length | 80 | 10 | 5 | 2.5
// | commonPayload is common to realtime, hi/low, and WOD, These are all used to calculate hi/low
Structure: commonRtMinmaxWodPayload_t,file:commonDownlink.h
// | Field Name | Code Name | Size (Bits) | Type | C Type | Conversion | Label | Description | Bit Offset | Byte Offset | Short Offset | Long offset | Module | Module_num | Module_Line | Line_Type
 | Available | FSAvailable | 32 | Unsigned |  | 11 | KB | Space left in the file system | 0 | 0 | 0 | 0 | File Storage | 3 | 1 | 0
 | Total Files | FSTotalFiles | 16 | Unsigned |  | 12 | - | Total files in the file system | 32 | 4 | 2 | 1 | File Storage | 3 | 2 | 0
 | Bytes Queued | UploadQueueBytes | 8 | Unsigned |  | 2 | - | Bytes reserved by the upload queue | 48 | 6 | 3 | 1.5 | File Storage | 3 | 3 | 0
 | Files Queued | UploadQueueFiles | 8 | Unsigned |  | 2 | - | Files in the tmp folder queued to upload | 56 | 7 | 3.5 | 1.75 | File Storage | 3 | 4 | 0
 | RF Power | TXPower | 8 | uint8_t |  | 4 | mW | TX RF Power | 64 | 8 | 4 | 2 | Radio | 4 | 1 | 0
 | RSSI | RX0RSSI | 8 | Unsigned |  | 6 | dBm | RSSI for Receiver 0 | 72 | 9 | 4.5 | 2.25 | Receiver 1 | 5 | 1 | 0
 | RSSI | RX1RSSI | 8 | Unsigned |  | 6 | dBm | RSSI for Receiver 1 | 80 | 10 | 5 | 2.5 | Receiver 2 | 6 | 1 | 0
 | RSSI | RX2RSSI | 8 | Unsigned |  | 6 | dBm | RSSI for receiver 2 | 88 | 11 | 5.5 | 2.75 | Receiver 3 | 7 | 1 | 0
 | RSSI | RX3RSSI | 8 | Unsigned |  | 6 | dBm | RSSI for receiver 3 | 96 | 12 | 6 | 3 | Receiver 4 | 8 | 1 | 0
 | CPU Temp | IHUTemp | 8 | Unsigned |  | 9 | C | Computer temperature | 104 | 13 | 6.5 | 3.25 | Computer | 2 | 1 | 0
 | PA Temp | PATemp | 8 | Unsigned |  | 9 | C | Power Amplifier Temperature | 112 | 14 | 7 | 3.5 | Radio | 4 | 2 | 0
 | Power Temp | PowerTemp | 8 | Unsigned |  | 9 | C | Power Supply Temperature | 120 | 15 | 7.5 | 3.75 | Power | 9 | 1 | 0
 | 3V3 | VoltageVal3v3 | 16 | Unsigned |  | 14 | mV | Voltage of the 3V3 rail | 128 | 16 | 8 | 4 | Power | 9 | 2 | 0
 | 5V | VoltageVal5v | 16 | Unsigned |  | 14 | mV | Voltage of the 5V rail | 144 | 18 | 9 | 4.5 | Power | 9 | 3 | 0
 | 1V2 | VoltageVal1v2 | 16 | Unsigned |  | 14 | mV | Voltage of the 1V2 rail | 160 | 20 | 10 | 5 | Power | 9 | 4 | 0
 | Battery | VoltageValBattery | 16 | Unsigned |  | 14 | mV | Voltage of the battery | 176 | 22 | 11 | 5.5 | Power | 9 | 5 | 0
END |  |  |  |  |  |  |  | Totals: | 192 | 24 | 12 | 6
// | commonPayload2 is common to realtime, hi/low, and WOD, but it is not compared for hi/low. It is fetched fresh.
Structure: commonRtWodPayload_t,file:common2Downlink.h
ifdef LEGACY_IHU
 | Power Radios | PowerFlagAx5043 | 1 | Unsigned |  | 1 | - | Radio Power is enabled | 0 | 0 | 0 | 0 | Radio | 4 | 7 | 0
 | Pad155 | pad202 | 7 | Unsigned |  | 0 | - | Pad | 1 | 0.125 | 0.0625 | 0.03125 | NONE | 0 | 0 | 0
 | Auto Safe Allowed | AutoSafeAllowed | 1 | Unsigned |  | 1 | - | Autosafe Allowed | 8 | 1 | 0.5 | 0.25 | Computer | 2 | 2 | 0
 | Auto Safe | AutoSafeModeActive | 1 | Unsigned |  | 1 | - | Autosafe Mode Active | 9 | 1.125 | 0.5625 | 0.28125 | Computer | 2 | 3 | 0
 | PB Enabled | pbEnabled | 1 | Unsigned |  | 1 | - | Pacsat Broadcast is available for use | 10 | 1.25 | 0.625 | 0.3125 | File Storage | 3 | 5 | 0
 | Uplink Enabled | uplinkEnabled | 1 | Unsigned |  | 1 | - | Pacsat file upload is available for use | 11 | 1.375 | 0.6875 | 0.34375 | File Storage | 3 | 6 | 0
 | Digi Enabled | DigiEnabled | 1 | Unsigned |  | 1 | - | Packet Digipeater is enabled | 12 | 1.5 | 0.75 | 0.375 | File Storage | 3 | 7 | 0
 | Power 5V | PowerFlag5V | 1 | Unsigned |  | 1 | - | 5V Power is enabled | 13 | 1.625 | 0.8125 | 0.40625 | Computer | 2 | 8 | 0
 | Power LNA | PowerFlagLNA | 1 | Unsigned |  | 1 | - | LNA is power is enabled | 14 | 1.75 | 0.875 | 0.4375 | Radio | 4 | 5 | 0
 | Power SSPA | PowerFlagSSPA | 1 | Unsigned |  | 1 | - | SSPA Power is enabled | 15 | 1.875 | 0.9375 | 0.46875 | Radio | 4 | 6 | 0
endif
ifdef RTIHU
 | Pad155 | pad202 | 7 | Unsigned |  | 0 | - | Pad | 0 | 0 | 0 | 0 | NONE | 0 | 0 | 0
 | Power Radios | PowerFlagAx5043 | 1 | Unsigned |  | 1 | - | Radio Power is enabled | 7 | 0.875 | 0.4375 | 0.21875 | Radio | 4 | 7 | 0
 | Power SSPA | PowerFlagSSPA | 1 | Unsigned |  | 1 | - | SSPA Power is enabled | 8 | 1 | 0.5 | 0.25 | Radio | 4 | 6 | 0
 | Power LNA | PowerFlagLNA | 1 | Unsigned |  | 1 | - | LNA is power is enabled | 9 | 1.125 | 0.5625 | 0.28125 | Radio | 4 | 5 | 0
 | Power 5V | PowerFlag5V | 1 | Unsigned |  | 1 | - | 5V Power is enabled | 10 | 1.25 | 0.625 | 0.3125 | Computer | 2 | 8 | 0
 | Digi Enabled | DigiEnabled | 1 | Unsigned |  | 1 | - | Packet Digipeater is enabled | 11 | 1.375 | 0.6875 | 0.34375 | File Storage | 3 | 7 | 0
 | Uplink Enabled | uplinkEnabled | 1 | Unsigned |  | 1 | - | Pacsat file upload is available for use | 12 | 1.5 | 0.75 | 0.375 | File Storage | 3 | 6 | 0
 | PB Enabled | pbEnabled | 1 | Unsigned |  | 1 | - | Pacsat Broadcast is available for use | 13 | 1.625 | 0.8125 | 0.40625 | File Storage | 3 | 5 | 0
 | Auto Safe | AutoSafeModeActive | 1 | Unsigned |  | 1 | - | Autosafe Mode Active | 14 | 1.75 | 0.875 | 0.4375 | Computer | 2 | 3 | 0
 | Auto Safe Allowed | AutoSafeAllowed | 1 | Unsigned |  | 1 | - | Autosafe Allowed | 15 | 1.875 | 0.9375 | 0.46875 | Computer | 2 | 2 | 0
endif
 | Log Level | LogLevel | 8 | Unsigned |  | 2 | - | The current logging level | 16 | 2 | 1 | 0.5 | Telem & Control | 1 | 7 | 0
 | Time Period | TimePeriod | 8 | Unsigned |  | 7 | min | The period between time packets | 24 | 3 | 1.5 | 0.75 | Telem & Control | 1 | 2 | 0
 | Telem Period | TelemPeriod | 8 | Unsigned |  | 7 | min | The period between telemetry packets | 32 | 4 | 2 | 1 | Telem & Control | 1 | 3 | 0
 | WOD Period | WodPeriod | 8 | Unsigned |  | 7 | min | The time between WOD saves | 40 | 5 | 2.5 | 1.25 | Telem & Control | 1 | 4 | 0
 | Max WOD Size | MaxWodFileSize | 8 | Unsigned |  | 8 | KB | The maximum size of a WOD file before it is added to the directory | 48 | 6 | 3 | 1.5 | Telem & Control | 1 | 5 | 0
 | Max EXP Size | MaxExpFileSize | 8 | Unsigned |  | 8 | KB | The maximum size of a experiment file before it is added to the directory | 56 | 7 | 3.5 | 1.75 | Telem & Control | 1 | 6 | 0
 | PB Status Period | PbStatusPeriod | 8 | Unsigned |  | 7 | min | The period between Pacsat Broadcast Status packets | 64 | 8 | 4 | 2 | File Storage | 3 | 8 | 0
 | PB Timeout | PbTimeout | 8 | Unsigned |  | 7 | min | The maximum time a client can be on the PB | 72 | 9 | 4.5 | 2.25 | File Storage | 3 | 9 | 0
 | Uplink Status Period | UplinkStatusPeriod | 8 | Unsigned |  | 7 | min | The period between uplink status packets | 80 | 10 | 5 | 2.5 | File Storage | 3 | 10 | 0
 | SW Cmd Cnt | swCmdCnt | 8 | uint8_t |  | 2 | - | Number of software commands since last reset | 88 | 11 | 5.5 | 2.75 | Telem & Control | 1 | 10 | 0
 | Min/Max Resets | TLMresets | 8 | Unsigned |  | 2 | - | Number of times command stations reset stored telemetry | 96 | 12 | 6 | 3 | Telem & Control | 1 | 8 | 0
 | Filler | pad203 | 24 | Unsigned |  | 0 | - | Fill to align to 32 bits | 104 | 13 | 6.5 | 3.25 | NONE | 0 | 0 | 0
 | Cmd Ring | swCmds | 32 | Unsigned |  | 0 | - | Command Ring showing last 4 commands | 128 | 16 | 8 | 4 | Telem & Control | 1 | 9 | 0
 | MRAM0 Status | MRAMstatus0 | 8 | uint8_t |  | 0 | - | Status of MRAM0 | 160 | 20 | 10 | 5 | Computer | 2 | 4 | 0
 | MRAM1 Status | MRAMstatus1 | 8 | uint8_t |  | 0 | - | Status of MRAM1 | 168 | 21 | 10.5 | 5.25 | Computer | 2 | 5 | 0
 | MRAM2 Status | MRAMstatus2 | 8 | uint8_t |  | 0 | - | Status of MRAM2 | 176 | 22 | 11 | 5.5 | Computer | 2 | 6 | 0
 | MRAM3 Status | MRAMstatus3 | 8 | uint8_t |  | 0 | - | Status of MRAM3 | 184 | 23 | 11.5 | 5.75 | Computer | 2 | 7 | 0
 | Pwr Mode | TXPwrMode | 8 | uint8_t |  | 5 | - | TX Power Mode | 192 | 24 | 12 | 6 | Radio | 4 | 3 | 0
 | Modulation | TxModMode | 8 | uint8_t |  | 13 | - | The modulation mode of the TX | 200 | 25 | 12.5 | 6.25 | Radio | 4 | 4 | 0
 | Pwr Mode | RX0PwrMode | 8 | Unsigned |  | 5 | - | RX0 Power Mode | 208 | 26 | 13 | 6.5 | Receiver 1 | 5 | 2 | 0
 | Pwr Mode | RX1PwrMode | 8 | Unsigned |  | 5 | - | RX1Power Mode | 216 | 27 | 13.5 | 6.75 | Receiver 2 | 6 | 2 | 0
 | Pwr Mode | RX2PwrMode | 8 | Unsigned |  | 5 | - | RX2 Power Mode | 224 | 28 | 14 | 7 | Receiver 3 | 7 | 2 | 0
 | Pwr Mode | RX3PwrMode | 8 | Unsigned |  | 5 | - | RX3 Power Mode | 232 | 29 | 14.5 | 7.25 | Receiver 4 | 8 | 2 | 0
 | Modulation | RX0ModMode | 8 | Unsigned |  | 13 | - | RX0 Modulation | 240 | 30 | 15 | 7.5 | Receiver 1 | 5 | 3 | 0
 | Modulation | RX1ModMode | 8 | Unsigned |  | 13 | - | RX1 Modulation | 248 | 31 | 15.5 | 7.75 | Receiver 2 | 6 | 3 | 0
 | Modulation | RX2ModMode | 8 | Unsigned |  | 13 | - | RX2 Modulation | 256 | 32 | 16 | 8 | Receiver 3 | 7 | 3 | 0
 | Modulation | RX3ModMode | 8 | Unsigned |  | 13 | - | RX3 Modulation | 264 | 33 | 16.5 | 8.25 | Receiver 4 | 8 | 3 | 0
 | Into AutoSafe | IntoAutoSafe | 8 | Unsigned |  | 2 | mV | The voltage threshold to decide if the spacecraft automatically enters safe mode | 272 | 34 | 17 | 8.5 | Computer | 2 | 9 | 0
 | Outof AutoSafe | OutofAutoSafe | 8 | Unsigned |  | 2 | mV | The voltage threshold to decide if the spacecraft automatically exits safe mode | 280 | 35 | 17.5 | 8.75 | Computer | 2 | 10 | 0
END |  |  |  |  |  |  |  | Total Length | 192 | 24 | 12 | 6
//
Structure: realtimeSpecific_t, file:realtimeDownlink.h
 | Pad | pad2 | 32 | uint8_t |  | 0 | - | Pad | 0 | 0 | 0 | 0 | NONE | 0 | 0 | 0
END |  |  |  |  |  |  |  | Total Length | 32 | 4 | 2 | 1
Structure: maxSpecific_t, file: maxDownlink.h
 | Max Last Chg Secs | maxTimestampUptime | 32 | unsigned |  | 0 | s | Timestamp Resets | 0 | 0 | 0 | 0 | NONE | 0 | 0 | 0
 | Max Last Change | maxTimestampEpoch | 16 | Unsigned |  | 0 |  | Timestamp uptime | 32 | 4 | 2 | 1 | NONE | 0 | 0 | 0
 | Max CRC Errors | maxCRCerror | 8 | unsigned |  | 0 | - | CRC Error for the Max Payload | 48 | 6 | 3 | 1.5 | NONE | 0 | 0 | 0
 | Filler | pad3 | 8 |  |  | 0 | - | Make same length as WOD | 56 | 7 | 3.5 | 1.75 | NONE | 0 | 0 | 0
END |  |  |  |  |  |  |  | Total Length | 64 | 8 | 4 | 2
Structure: minSpecific_t, file: minDownlink.h
 | Min Last Chg Secs | minTimestampUptime | 32 |  |  | 0 | s | Timestamp Resets | 0 | 0 | 0 | 0 | NONE | 0 | 0 | 0
 | Min Last Change | minTimestampEpoch | 16 | Unsigned |  | 0 |  | Timestamp uptime | 32 | 4 | 2 | 1 | NONE | 0 | 0 | 0
 | Last Reset Time | minmaxResetEpoch | 16 |  |  | 0 |  | MinMax Reset Epoch | 48 | 6 | 3 | 1.5 | NONE | 0 | 0 | 0
 | Min Max Reset Seconds | minmaxResetSecs | 32 |  |  | 0 |  | MinMax Reset Secs | 64 | 8 | 4 | 2 | NONE | 0 | 0 | 0
 | Min CRC Errors | minCRCerror | 8 | unsigned |  | 0 | - | CRC Error for the min payload | 96 | 12 | 6 | 3 | NONE | 0 | 0 | 0
 | Filler | pad4 | 24 | uint8_t |  | 0 | - |  | 104 | 13 | 6.5 | 3.25 | NONE | 0 | 0 | 0
END |  |  |  |  |  |  |  | Total Length | 128 | 16 | 8 | 4
//
Structure:wodSpecific_t,file:wodSpecificDownlink.h
 | Uptime | WODTimestampUptime | 32 | Unsigned |  | 0 | s | Time Whole Orbit Data was collected | 0 | 0 | 0 | 0 | Telem & Control | 1 | 11 | 0
 | Data Capture Time | WODTimestampReset | 16 | Unsigned |  | 0 | - | Time Whole Orbit Data was collected | 32 | 4 | 2 | 1 | Telem & Control | 1 | 12 | 0
 | CRC Error | WodCRCError | 8 | Unsigned |  | 0 | - | CRC Error for the WOD Payload | 48 | 6 | 3 | 1.5 | Telem & Control | 1 | 13 | 0
 | Filler | pad5 | 8 | uint8_t |  | 0 | - | Pad | 56 | 7 | 3.5 | 1.75 | NONE | 0 | 0 | 0
END |  |  |  |  |  |  |  | Totals: | 64 | 8 | 4 | 2
Structure:rt1Errors_t,file:rt1ErrorsDownlink.h |  |  |  |  |  |  |  |  |  |  |  |  | Module
// | Field Name | Code Name | Size (Bits) | Type | C Type | Conversion | Label | Description | Bit Offset | Byte Offset | Short Offset | Long offset |  | Module_num | Module_Line | Line_Type
 | Watchdog Tasks | wdReports | 9 | Unsigned |  | 2 | - | x | 0 | 0 | 0 | 0 | Computer | 2 | 1 | 0
 | Cause of reset | errorCode | 5 | Unsigned |  | 2 | - | x | 9 | 1.125 | 0.5625 | 0.28125 | Computer | 2 | 2 | 0
 | Task at reset | taskNumber | 4 | Unsigned |  | 2 | - | Task executing at reset | 14 | 1.75 | 0.875 | 0.4375 | Computer | 2 | 3 | 0
 | Previous task | previousTask | 4 | Unsigned |  | 2 | - | Previous task before reset | 18 | 2.25 | 1.125 | 0.5625 | Computer | 2 | 4 | 0
 | Resets in a row | earlyResetCount | 3 | Unsigned |  | 2 | - | Resets in a row that have been too soon | 22 | 2.75 | 1.375 | 0.6875 | Computer | 2 | 5 | 0
 | Early reset | wasStillEarlyInBoot | 1 | Unsigned |  | 2 | - | Was this reset still early in boot | 25 | 3.125 | 1.5625 | 0.78125 | Computer | 2 | 6 | 0
 | Data Valid | valid | 1 | Unsigned |  | 1 | - | x | 26 | 3.25 | 1.625 | 0.8125 | Computer | 2 | 7 | 0
 | pad to 32 bits | pad6 | 5 | Unsigned |  | 0 | - | x | 27 | 3.375 | 1.6875 | 0.84375 | NONE | 0 | 0 | 0
 | Error Data | errorData | 32 | Unsigned |  | 2 | - | x | 32 | 4 | 2 | 1 | Computer | 2 | 8 | 0
 | Primary SRAM Corrected Addr 1 | RAMCorAddr1 | 32 | unsigned |  | 0 | - | x | 64 | 8 | 4 | 2 | Memory | 3 | 1 | 0
 | Primary SRAM Corrected Addr 2 | RAMCorAddr2 | 32 | Unsigned |  | 0 | - | x | 96 | 12 | 6 | 3 | Memory | 3 | 2 | 0
 | Primary Flash Corrected Addr 1 | ROMCorAddr1 | 32 | unsigned |  | 0 | - | x | 128 | 16 | 8 | 4 | Memory | 3 | 3 | 0
 | Primary Flash Corrected Addr 2 | ROMCorAddr2 | 32 | Unsigned |  | 0 | - | x | 160 | 20 | 10 | 5 | Memory | 3 | 4 | 0
 | Cmd CRC Fails | DCTCmdFailCRCCnt | 8 | Unsigned |  | 0 | - | Count of commands failing CRC check | 192 | 24 | 12 | 6 | Commanding | 5 | 1 | 0
 | Cmd Time Fails | DCTCmdFailTimeCnt | 8 | Unsigned |  | 0 | - | Count of commands failing the time check | 200 | 25 | 12.5 | 6.25 | Commanding | 5 | 2 | 0
 | Cmd Auth Fails | DCTCmdFailAuthenticateCnt | 8 | Unsigned |  | 0 | - | Count of commands failing authentication | 208 | 26 | 13 | 6.5 | Commanding | 5 | 3 | 0
 | Cmd Fail count | DCTCmdFailCommandCnt | 8 | Unsigned |  | 0 | - | Count of commands failing | 216 | 27 | 13.5 | 6.75 | Commanding | 5 | 4 | 0
 | Cmds wrong NS | DCTCmdFailNamespaceCnt | 8 | Unsigned |  | 0 | - | Count of commands with wrong namespace | 224 | 28 | 14 | 7 | Commanding | 5 | 5 | 0
 | I2C1 errors | I2C1ErrorCnt | 8 | Unsigned |  | 0 | - | I2C1 errors | 232 | 29 | 14.5 | 7.25 | Buses | 4 | 1 | 0
 | I2C2 errors | I2C2ErrorCnt | 8 | Unsigned |  | 0 | - | I2C2 errors | 240 | 30 | 15 | 7.5 | Buses | 4 | 2 | 0
 | I2C1 resets | I2C1ResetCnt | 8 | Unsigned |  | 0 | - | I2C1 resets | 248 | 31 | 15.5 | 7.75 | Buses | 4 | 3 | 0
 | I2C2 resets | I2C2ResetCnt | 8 | Unsigned |  | 0 | - | I2C2 resets | 256 | 32 | 16 | 8 | Buses | 4 | 4 | 0
 | I2C1 retires | I2C1RetryCnt | 8 | Unsigned |  | 0 | - | I2C1 retires | 264 | 33 | 16.5 | 8.25 | Buses | 4 | 5 | 0
 | I2C2 retries | I2C2RetryCnt | 8 | Unsigned |  | 0 | - | I2C2 retries | 272 | 34 | 17 | 8.5 | Buses | 4 | 6 | 0
 | SPI retrries | SPIRetryCnt | 8 | Unsigned |  | 0 | - | SPI retrries | 280 | 35 | 17.5 | 8.75 | Buses | 4 | 7 | 0
 | MRAM fails | MramCRCCnt | 8 | Unsigned |  | 0 | - | MRAM fails | 288 | 36 | 18 | 9 | Memory | 3 | 5 | 0
 | MRAM Read errs | MramRdErrorCnt | 8 | Unsigned |  | 0 | - | MRAM Read errs | 296 | 37 | 18.5 | 9.25 | Memory | 3 | 6 | 0
 | MRAM Write errs | MramWtErrorCnt | 8 | Unsigned |  | 0 | - | MRAM Write errs | 304 | 38 | 19 | 9.5 | Memory | 3 | 7 | 0
 | RT1FlashCorrectable Count | FlashCorCnt | 8 | Unsigned |  | 0 | - | RT1FlashCorrectable Count | 312 | 39 | 19.5 | 9.75 | Memory | 3 | 8 | 0
 | RT1 Ram Even Bank Correctable Count | RamEvenCorCnt | 8 | Unsigned |  | 0 | - | RT1 Ram Even Bank Correctable Count | 320 | 40 | 20 | 10 | Memory | 3 | 9 | 0
 | RT1 Ram Odd Bank Correctable Count | RamOddCorCnt | 8 | Unsigned |  | 0 | - | RT1 Ram Odd Bank Correctable Count | 328 | 41 | 20.5 | 10.25 | Memory | 3 | 10 | 0
 | RT1PLLSlip | PLLSlipCnt | 8 | Unsigned |  | 0 | - | RT1PLLSlip | 336 | 42 | 21 | 10.5 | Computer | 2 | 9 | 0
 | RT1ClockMonitorFail | ClockMonitorFailCnt | 8 | Unsigned |  | 0 | - | RT1ClockMonitorFail | 344 | 43 | 21.5 | 10.75 | Computer | 2 | 10 | 0
 | RT1VIMRamParity | VIMRamParityCnt | 8 | Unsigned |  | 0 | - | RT1VIMRamParity | 352 | 44 | 22 | 11 | Memory | 3 | 11 | 0
 | RT1CAN1RamParity | CAN1RamParityCnt | 8 | Unsigned |  | 0 | - | RT1CAN1RamParity | 360 | 45 | 22.5 | 11.25 | Memory | 3 | 12 | 0
 | RT1CAN2RamParity | CAN2RamParityCnt | 8 | Unsigned |  | 0 | - | RT1CAN2RamParity | 368 | 46 | 23 | 11.5 | Memory | 3 | 13 | 0
 | RT1DCC1Error | DCC1ErrorCnt | 8 | Unsigned |  | 0 | - | RT1DCC1Error | 376 | 47 | 23.5 | 11.75 | Memory | 3 | 14 | 0
 | RT1DCC2Error | DCC2ErrorCnt | 8 | Unsigned |  | 0 | - | RT1DCC2Error | 384 | 48 | 24 | 12 | Memory | 3 | 15 | 0
 | RT1N2HET2RamParity | N2HET2RamParityCnt | 8 | Unsigned |  | 0 | - | RT1N2HET2RamParity | 392 | 49 | 24.5 | 12.25 | Computer | 2 | 11 | 0
 | RT1IOMMAccvio | IOMMAccvioCnt | 8 | Unsigned |  | 0 | - | RT1IOMMAccvio | 400 | 50 | 25 | 12.5 | Computer | 2 | 12 | 0
 | Non-fatal error count | nonFatalCnt | 8 | Unsigned |  | 0 | - | Non-fatal error count | 408 | 51 | 25.5 | 12.75 | Computer | 2 | 13 | 0
 | RTIHU1 Version Number | SWVersion | 16 | Unsigned | uint8_t | 0 | - | RTIHU1 Version Number | 416 | 52 | 26 | 13 | Computer | 2 | 14 | 0
 | Dropped Pkts | TxDroppedPkts | 8 | Unsigned |  | 2 | - | Dropped Pkts | 432 | 54 | 27 | 13.5 | Computer | 2 | 15 | 0
 | RTOS Failures | RTOSfailure | 8 | Unsigned |  | 2 | - | RTOS Errs | 440 | 55 | 27.5 | 13.75 | Computer | 2 | 16 | 0
 | REDFS Errors | REDFSIOerror | 8 | Unsigned |  | 2 | - | RED File System Errors | 448 | 56 | 28 | 14 | Computer | 2 | 17 | 0
 | Fill to 32-bits | pad7 | 24 | Unisgned |  | 0 | - | x | 456 | 57 | 28.5 | 14.25 | NONE | 0 | 0 | 0
END |  |  |  |  |  |  |  |  | 480 | 60 | 30 | 15

Sheet: Sheet2
Payloads per Frame | Data Bytes per Frame | Codewords | Total Bytes per Frame | Bits | Time to Downlink
1 | 72 | 1 | 104 | 1040 | 0.8666666667
6 | 392 | 2 | 456 | 4560 | 3.8
7 | 456 | 3 | 552 | 5520 | 4.6
8 | 520 | 3 | 616 | 6160 | 5.133333333
9 | 584 | 3 | 680 | 6800 | 5.666666667
10 | 648 | 3 | 744 | 7440 | 6.2
11 | 712 | 4 | 840 | 8400 | 7
12 | 776 | 4 | 904 | 9040 | 7.533333333
13 | 840 | 4 | 968 | 9680 | 8.066666667
14 | 904 | 5 | 1064 | 10640 | 8.866666667
15 | 968 | 5 | 1128 | 11280 | 9.4
16 | 1032 | 5 | 1192 | 11920 | 9.933333333
17 | 1096 | 5 | 1256 | 12560 | 10.46666667
18 | 1160 | 6 | 1352 | 13520 | 11.26666667
