AMSAT-NA/PacSatDocs/Hardware/Rev_D/PacSat_Dev_RevD_240614/PacSat_Dev_RecC_230926.xlsx

Source: | /home/bob/Projects/PacSat_Dev_RecC_230926/PacSat_Dev_RecC_230926.kicad_sch
Date: | Wed 27 Sep 2023 09:53:59 PM CDT
Tool: | Eeschema 7.0.7-7.0.7~ubuntu22.04.1
Generator: | /usr/share/kicad/plugins/bom_csv_grouped_by_value.py
Component Count: | 336
Collated Components:
Item | Qty | Reference(s) | Value |  | LibPart | Footprint | Datasheet | DNP | Sim.Device | Sim.Pins | Sim.Type
1 | 15 | C2 C3 C4 C5 C6 C7 C8 C9 C10 C31 C32 C76 C77 C78 C79 | 100n | KGM15BR71E104KT (https://www.mouser.com/ProductDetail/KYOCERA-AVX/KGM15BR71E104KT) | Device:C | Capacitor_SMD:C_0603_1608Metric_Pad1.08x0.95mm_HandSolder | ~
2 | 1 | C27 | 6p | 06033A6R0DAT4A | Device:C | Capacitor_SMD:C_0603_1608Metric_Pad1.08x0.95mm_HandSolder | ~
3 | 3 | C28 C86 C87 | 470n | GCM188R71E474KA64J | Device:C | Capacitor_SMD:C_0603_1608Metric_Pad1.08x0.95mm_HandSolder | ~
4 | 2 | C29 C30 | 22u | GRT31CC71E226ME13K | Device:C | Capacitor_SMD:C_0603_1608Metric_Pad1.08x0.95mm_HandSolder | ~
5 | 2 | C88 C93 | 10u | 885012214004 | Device:C | Capacitor_SMD:C_2220_5650Metric_Pad1.97x5.40mm_HandSolder | ~
6 | 2 | C89 C90 | 1000p | 06033C102K4Z2A | Device:C | Capacitor_SMD:C_0603_1608Metric_Pad1.08x0.95mm_HandSolder | ~
7 | 3 | C91 C94, C95 | 22u | 22203C226KAT2A | Device:C | Capacitor_SMD:C_2220_5650Metric_Pad1.97x5.40mm_HandSolder | ~
8 | 3 | C92 C96 C714 | 10u | GRJ31CC71E106KE11L | Device:C | Capacitor_SMD:C_0603_1608Metric_Pad1.08x0.95mm_HandSolder | ~
9 | 8 | C97 C98 C99 C100 C101 C121 C122 C123 | 1u | 08053C105KAT2A | Device:C | Capacitor_SMD:C_0805_2012Metric_Pad1.18x1.45mm_HandSolder | ~
10 | 17 | C102 C103 C159 C160 C163 C203 C204 C207 C303 C304 C307 C411 C412 C415 C504 C505 C508 | 10n | C0603C103K3HACAUTO | Device:C | Capacitor_SMD:C_0603_1608Metric_Pad1.08x0.95mm_HandSolder | ~
11 | 5 | C151 C152 C153 C402 C704 | NS | Not Used | Device:C | Capacitor_SMD:C_0603_1608Metric_Pad1.08x0.95mm_HandSolder | ~
12 | 1 | C154 | 5p1 | GRM0335C1E5R1BA01D | Device:C | Capacitor_SMD:C_0603_1608Metric_Pad1.08x0.95mm_HandSolder | ~
13 | 1 | C155 | 11p | 06033A110JAT4A | Device:C | Capacitor_SMD:C_0603_1608Metric_Pad1.08x0.95mm_HandSolder | ~
14 | 3 | C156 C406 C702 | 5p6 | 06033A5R6KAT2A | Device:C | Capacitor_SMD:C_0603_1608Metric_Pad1.08x0.95mm_HandSolder | ~
15 | 11 | C157 C158 C201 C202 C301 C302 C409 C410 C501 C701 C703 | 4p3 | 06033A4R3BAT2A | Device:C | Capacitor_SMD:C_0603_1608Metric_Pad1.08x0.95mm_HandSolder | ~
16 | 5 | C161 C205 C305 C413 C506 | 6.8p | 06033A6R8JAT2A | Device:C | Capacitor_SMD:C_0603_1608Metric_Pad1.08x0.95mm_HandSolder | ~
17 | 7 | C162 C206 C306 C407 C408 C414 C507 | 10p | 06033A100JAT2A | Device:C | Capacitor_SMD:C_0603_1608Metric_Pad1.08x0.95mm_HandSolder | ~
18 | 2 | C401 C403 | 27p | 06033A270JAT2A | Device:C | Capacitor_SMD:C_0603_1608Metric_Pad1.08x0.95mm_HandSolder | ~
19 | 1 | C404 | 12p | 06033A120JAT2A | Device:C | Capacitor_SMD:C_0603_1608Metric_Pad1.08x0.95mm_HandSolder | ~
20 | 1 | C405 | 1p | 06033A1R0BAT2A | Device:C | Capacitor_SMD:C_0603_1608Metric_Pad1.08x0.95mm_HandSolder | ~
21 | 2 | C502 C503 | 22p | 06033A220JAT2A | Device:C | Capacitor_SMD:C_0603_1608Metric_Pad1.08x0.95mm_HandSolder | ~
22 | 1 | C601 | 2.2 nF | 02013C222KAT2A | Device:C | Capacitor_SMD:C_0603_1608Metric_Pad1.08x0.95mm_HandSolder | ~
23 | 3 | C602 C603 C607 | 0.1 u | C0603C104K3RAC7013 | Device:C | Capacitor_SMD:C_0603_1608Metric_Pad1.08x0.95mm_HandSolder | ~
24 | 4 | C604 C605 C606 C707 | 1u | C0603C105K3RAC7411 | Device:C | Capacitor_SMD:C_0603_1608Metric_Pad1.08x0.95mm_HandSolder | ~
25 | 4 | C651 C652 C653 C654 | 0.1u | C0603C104K3RAC7013 | Device:C | Capacitor_SMD:C_0603_1608Metric_Pad1.08x0.95mm_HandSolder | ~
26 | 5 | C705 C713 C715 C716 C717 | 2200p | 06033A222JAT2A | Device:C | Capacitor_SMD:C_0603_1608Metric_Pad1.08x0.95mm_HandSolder | ~
27 | 1 | C706 | 18p | 06033A180JAT2A | Device:C | Capacitor_SMD:C_0603_1608Metric_Pad1.08x0.95mm_HandSolder | ~
28 | 2 | C708 C711 | 15p | 06033A150JAT2A | Device:C | Capacitor_SMD:C_0603_1608Metric_Pad1.08x0.95mm_HandSolder | ~
29 | 2 | C709 C712 | 100p | 06033A101JAT2A | Device:C | Capacitor_SMD:C_0603_1608Metric_Pad1.08x0.95mm_HandSolder | ~
30 | 1 | C710 | 56p | 06033A560JAT2A | Device:C | Capacitor_SMD:C_0603_1608Metric_Pad1.08x0.95mm_HandSolder | ~
31 | 1 | D2 | RED | LS Q976-NR-1 | PACSAT_DEV_misc:LED | LED_SMD:LED_0603_1608Metric_Pad1.05x0.95mm_HandSolder
32 | 1 | D3 | YEL | SML-D12Y1WT86 | PACSAT_DEV_misc:LED | LED_SMD:LED_0603_1608Metric_Pad1.05x0.95mm_HandSolder
33 | 1 | D4 | GRN | SML-D12D1WT86 | PACSAT_DEV_misc:LED | LED_SMD:LED_0603_1608Metric_Pad1.05x0.95mm_HandSolder
34 | 1 | D5 | LED | LS Q976-NR-1 | Device:LED | LED_SMD:LED_1206_3216Metric_Pad1.42x1.75mm_HandSolder | ~
35 | 2 | D26 D27 | RB521CS30L,315 | RB521CS30L,315 | Diode:1N914 | Diode_SMD:D_0603_1608Metric | http://www.vishay.com/docs/85622/1n914.pdf |  | D | 1=K 2=A
36 | 2 | FB651 FB652 | FerriteBead_Small | FBMH1608HM101-TV | Device:FerriteBead_Small | Resistor_SMD:R_0603_1608Metric_Pad0.98x0.95mm_HandSolder | ~
37 | 2 | FB701 FB702 | 2743019447 | 2743019447 | Device:R | Resistor_SMD:R_0603_1608Metric_Pad0.98x0.95mm_HandSolder | ~
38 | 8 | H10 H11 H12 H13 H14 H15 H16 H17 | Wire_Hole | Not Used | PACSAT_DEV_misc:CUBESAT_MOUNT_HOLE_1 | PacSatDev_misc:Wire_Hole
39 | 4 | H101 H102 H103 H104 | CUBESAT_MOUNT_HOLE | Not Used | PACSAT_DEV_misc:CUBESAT_MOUNT_HOLE_1 | PacSatDev_misc:CUBESAT_MOUNT_HOLE
40 | 1 | J2 | CONN_02X05 | FTSH-105-01-L-DV-001-K | PACSAT_DEV_misc:CONN_02X05 | PacSatDev_samtec:FTSH-105-01-L-DV-K
41 | 1 | J801 | Conn_02x05_Odd_Even | 68046-605PLF | Connector_Generic:Conn_02x05_Odd_Even | Connector_PinHeader_2.54mm:PinHeader_2x05_P2.54mm_Vertical | ~
42 | 2 | JP86 JP87 | Disable Watchdog | Not Used | PACSAT_DEV_misc:Jumper_NO_Small | Jumper:SolderJumper-2_P1.3mm_Open_RoundedPad1.0x1.5mm
43 | 1 | JP88 | Disable WD Shutdown | Not Used | PACSAT_DEV_misc:Jumper_NO_Small | Jumper:SolderJumper-2_P1.3mm_Open_RoundedPad1.0x1.5mm
44 | 3 | L86 L87 L88 | 3u3 | B82422T1332K000 | Device:L | Inductor_SMD:L_1210_3225Metric_Pad1.42x2.65mm_HandSolder | ~
45 | 6 | L151 L158 L201 L301 L408 L505 | 0 | MCT0603MZ0000ZP500 | Device:L | PacSatDev_misc:L_Murata_LQH2MCNxxxx02_2.0x1.6mm | ~
46 | 2 | L152 L153 | 27n | LQG18HN27NJ00D | Device:L | PacSatDev_misc:L_Murata_LQH2MCNxxxx02_2.0x1.6mm | ~
47 | 3 | L154 L155 L702 | 43n | LQP03TN43NH02D | Device:L | PacSatDev_misc:L_Murata_LQH2MCNxxxx02_2.0x1.6mm | ~
48 | 2 | L156 L157 | 100n | LQG18HNR10J00D | Device:L | PacSatDev_misc:L_Murata_LQH2MCNxxxx02_2.0x1.6mm | ~
49 | 1 | L401 | 30 | LQP03TN20NH02D | Device:L | PacSatDev_misc:L_Murata_LQH2MCNxxxx02_2.0x1.6mm | ~
50 | 6 | L402 L403 L501 L502 L503 L504 | 68n | LQG15HN68NJ02D | Device:L | PacSatDev_misc:L_Murata_LQH2MCNxxxx02_2.0x1.6mm | ~
51 | 2 | L404 L405 | 120n | LQW18ASR12G0ZD | Device:L | PacSatDev_misc:L_Murata_LQH2MCNxxxx02_2.0x1.6mm | ~
52 | 2 | L406 L407 | 150n | LQW18ANR15J00D | Device:L | PacSatDev_misc:L_Murata_LQH2MCNxxxx02_2.0x1.6mm | ~
53 | 1 | L601 | 620nH | LQW21HNR47J00L | Device:L | PacSatDev_misc:L_Murata_LQH2MCNxxxx02_2.0x1.6mm | ~
54 | 1 | L602 | 120 nH | LQW18ASR12G0ZD | Device:L | PacSatDev_misc:L_Murata_LQH2MCNxxxx02_2.0x1.6mm | ~
55 | 1 | L701 | 100n | LQG18HNR10J00D | Device:L | PacSatDev_murata:L_0603 | ~
56 | 1 | L703 | 18n | LQG18HN18NJ00D | Device:L | PacSatDev_murata:L_0603 | ~
57 | 1 | L704 | 1n2 | LQG18HH1N2S00D | Device:L | PacSatDev_misc:L_Murata_LQH2MCNxxxx02_2.0x1.6mm | ~
58 | 2 | L705, L706 | 5n5 | LQG18HH5N6S00D | Device:L | PacSatDev_misc:L_Murata_LQH2MCNxxxx02_2.0x1.6mm | ~
59 | 1 | L707 | 16n6 | LQG18HH6N8J00D | Device:L | PacSatDev_misc:L_Murata_LQH2MCNxxxx02_2.0x1.6mm | ~
60 | 1 | L708 | 2n55 | LQG18HH2N7S00D | Device:L | PacSatDev_misc:L_Murata_LQH2MCNxxxx02_2.0x1.6mm | ~
61 | 1 | L709 | 8n1 | LQG18HH8N2J00D | Device:L | PacSatDev_misc:L_Murata_LQH2MCNxxxx02_2.0x1.6mm | ~
62 | 1 | L710 | 4n7 | LT6657AHMS8-2.5 | Device:L | PacSatDev_misc:L_Murata_LQH2MCNxxxx02_2.0x1.6mm | ~
63 | 18 | P100 P201 P202 P301 P302 P401 P501 P502 P602 P603 P604 P605 P606 P607 P608 P609 P610 P701 | U_FL | U.FL-R-SMT-1(10) | PACSAT_DEV_misc:U_FL | PacSatDev_misc:U_FL | Hirose Conn | 798-U.FL-R-SMT10
64 | 4 | P101 P601 P702 P703 | U_FL | U.FL-R-SMT-1(10) | PACSAT_DEV_misc:U_FL | PacSatDev_misc:U_FL
65 | 1 | P651 | Conn_04x26_Pin | PTHF-126-02-GF-Q-368 | PACSAT_DEV_misc:Conn_PC104 | PacSatDev_misc:PacSat_Dev_4_26 | ~
66 | 2 | PS601 PS602 | AD4PS+1 | AD4P5+1 | PACSAT_Minicircuits:AD4PS+1 | PacSatDev_MiniCircuits:CJ725
67 | 1 | Q601 | SAV-331+ | SAV-331+ | PACSAT_Minicircuits:SAV-331+ | PacSatDev_misc:TB-471
68 | 1 | Q602 | ~ | TPS1100 | PACSAT_DEV_misc:TPS1100 | Package_SO:SO-8_3.9x4.9mm_P1.27mm
69 | 1 | Q701 | ATF05MS004NT1 | ATF05MS004NT1 | PACSAT_DEV_misc:NMOS | Package_TO_SOT_SMD:SOT-89-3 | https://ngspice.sourceforge.io/docs/ngspice-manual.pdf |  | NMOS | 3=D 1=G 2=S | VDMOS
70 | 5 | R2 R3 R4 R5 R13 | 3k3 | CRCW060313K3FKEA | Device:R | Resistor_SMD:R_0603_1608Metric_Pad0.98x0.95mm_HandSolder | ~
71 | 4 | R6 R7 R8 R604 | 3K | MCT06030C3001FP500 | Device:R | Resistor_SMD:R_0603_1608Metric_Pad0.98x0.95mm_HandSolder | ~
72 | 4 | R9 R10 R11 R12 | 1k | TNPW06031K00FEEA | Device:R | Resistor_SMD:R_0603_1608Metric_Pad0.98x0.95mm_HandSolder | ~
73 | 1 | R14 | 2.4K | MCT06030C2401FP500 | Device:R | Resistor_SMD:R_0603_1608Metric_Pad0.98x0.95mm_HandSolder | ~
74 | 6 | R28 R29 R30 R31 R104 R111 | 4k7 | MCT06030C4701FP500 | Device:R | Resistor_SMD:R_0603_1608Metric_Pad0.98x0.95mm_HandSolder | ~
75 | 14 | R86 R87 R108 R109 R152 R153 R202 R203 R302 R303 R402 R403 R502 R503 | 0R | MCT0603MZ0000ZP500 | Device:R | Resistor_SMD:R_0603_1608Metric_Pad0.98x0.95mm_HandSolder | ~
76 | 3 | R88 R98 R99 | 4.7k | MCT06030C4701FP500 | Device:R | Resistor_SMD:R_0603_1608Metric_Pad0.98x0.95mm_HandSolder | ~
77 | 1 | R89 | 10 | TNPW060310R0FHTA | Device:R | Resistor_SMD:R_0603_1608Metric_Pad0.98x0.95mm_HandSolder | ~
78 | 4 | R90 R91 R105 R106 | 10k | MCT06030C1002FP500 | Device:R | Resistor_SMD:R_0603_1608Metric_Pad0.98x0.95mm_HandSolder | ~
79 | 2 | R92 R603 | 1K | TNPW06031K00FEEA | Device:R | Resistor_SMD:R_0603_1608Metric_Pad0.98x0.95mm_HandSolder | ~
80 | 3 | R93 R94 R96 | 45k8 1% | TNPW060345K9BEEA | Device:R | Resistor_SMD:R_0603_1608Metric_Pad0.98x0.95mm_HandSolder | ~
81 | 1 | R95 | 143k 1% | TNPW0603143KBEEN | Device:R | Resistor_SMD:R_0603_1608Metric_Pad0.98x0.95mm_HandSolder | ~
82 | 22 | R97 R100 R107 R110 R112 R114 R115 R117 R118 R119 R602 R651 R652 R801 R802 R803 R804 R805 R806 R807 R808 R809 | 10K | MCT06030C1002FP500 | Device:R | Resistor_SMD:R_0603_1608Metric_Pad0.98x0.95mm_HandSolder | ~
83 | 1 | R101 | PLTT1206Z2743BGTS | TNPW1206274KBEEA | Device:R | Resistor_SMD:R_1210_3225Metric_Pad1.30x2.65mm_HandSolder | ~
84 | 1 | R102 | PLTT1206Z0303BGTS | RC1206FR-0730KL | Device:R | Resistor_SMD:R_1210_3225Metric_Pad1.30x2.65mm_HandSolder | ~
85 | 1 | R103 | PLTT1206Z0011BGTS | MCA1206OD1000BP100 | Device:R | Resistor_SMD:R_0603_1608Metric_Pad0.98x0.95mm_HandSolder | ~
86 | 1 | R113 | 3.8K | TNPW06033K83BEEA | Device:R | Resistor_SMD:R_0603_1608Metric_Pad0.98x0.95mm_HandSolder | ~
87 | 6 | R151 R201 R301 R401 R501 R610 | 50 | TNPU060350R0BZEN00 | Device:R | Resistor_SMD:R_0603_1608Metric_Pad0.98x0.95mm_HandSolder | ~
88 | 1 | R601 | 5 Meg | MCT06030C4994FP500 | Device:R | Resistor_SMD:R_0603_1608Metric_Pad0.98x0.95mm_HandSolder | ~
89 | 1 | R605 | 2K | TNPW06032K00BYEN | Device:R | Resistor_SMD:R_0603_1608Metric_Pad0.98x0.95mm_HandSolder | ~
90 | 1 | R606 | 5K | RT0603BRE075KL | Device:R | Resistor_SMD:R_0603_1608Metric_Pad0.98x0.95mm_HandSolder | ~
91 | 1 | R607 | 1MEG | MCT06030C1004FP500 | Device:R | Resistor_SMD:R_0603_1608Metric_Pad0.98x0.95mm_HandSolder | ~
92 | 2 | R701 R702 | 22 | MCT06030C2209FP500 | Device:R | Resistor_SMD:R_0603_1608Metric_Pad0.98x0.95mm_HandSolder | ~
93 | 1 | T601 | ADT4-1WT+ | ADT4-1WT+ | PACSAT_Minicircuits:Transformer_1P_SS | RF_Mini-Circuits:Mini-Circuits_CD542_H2.84mm | ~
94 | 2 | TP1 TP2 | U_FL | U.FL-R-SMT-1(10) | PACSAT_DEV_misc:U_FL | PacSatDev_misc:U_FL SMD
95 | 1 | U2 | TMS570LS0914PGE | AMSAT Supplied | PACSAT_ICs:TMS570LS0914PGE | PacSatDev_ti:TQFP-144_20x20mm_Pitch0.5mm
96 | 1 | U26 | DS28E83Q+T | DS28E83Q+T | PACSAT_ICs:DS28E83 | PacSatDev_maxim:TDFN_T633_2
97 | 1 | U28 | MAX31331TETB+ | MAX31331TETB+ | PACSAT_ICs:MAX31331 | Package_DFN_QFN:TDFN-10-1EP_2x3mm_P0.5mm_EP0.9x2mm
98 | 2 | U29 U30 | MAX31725MTA+ | MAX31725MTA+ | PACSAT_ICs:MAX31725 | PacSatDev_maxim:TDFN_T833_2
99 | 4 | U76 U77 U78 U79 | MR25H40CDE | MR25H40CDE | PACSAT_ICs:MR25H40_2 | PacSatDev_everspin:MR2xH40_DFN_SmallFlag
100 | 1 | U86 | TPS7A7001DDA | TPS7A7001DDA | Regulator_Linear:TPS7A7001DDA | Package_SO:TI_SO-PowerPAD-8 | http://www.ti.com/lit/ds/symlink/tps7a7001.pdf
101 | 1 | U87 | MAX1556AEBT+ | MAX1556A | PACSAT_ICs:MAX1556A | PacSatDev_maxim:TDFN_T1033_1 | Analog Devices-Maxium | 700-MAX1556ETBT
102 | 1 | U88 | MAX1556A | MAX1556A | PACSAT_ICs:MAX1556A | PacSatDev_maxim:TDFN_T1033_1
103 | 1 | U89 | TPS22917DBV | TPS22917DBVR | Power_Management:TPS22917DBV | Package_TO_SOT_SMD:SOT-23-6 | http://www.ti.com/lit/ds/symlink/tps22917.pdf
104 | 2 | U90 U95 | STWD100NYWY3F | STWD100NYWY3F | PACSAT_ICs:STWD100NYWY3F | Package_TO_SOT_SMD:SOT-353_SC-70-5
105 | 4 | U91 U92 U93 U94 | MAX4995ALAUT | MAX4995ALAUT | PACSAT_ICs:MAX4995_1 | Package_TO_SOT_SMD:SOT-23-6_Handsoldering
106 | 5 | U156 U205 U305 U405 U505 | AX5043 | AMSAT Supplied | PACSAT_DEV_misc:AX5043 | PacSatDev_onsemi:QFN28
107 | 1 | U201 | RFShield_OnePiece | Not Used | PACSAT_DEV_misc:RF_SHIELD_BOX | PacSatDev_misc:RF_SHIELD_BMI_S_201_F_U201
108 | 1 | U206 | TLP3905 | TLP3905 | PACSAT_ICs:TLP3905 | Package_SO:SO-6_4.4x3.6mm_P1.27mm
109 | 1 | U301 | RFShield_OnePiece | Not Used | PACSAT_DEV_misc:RF_SHIELD_BOX | PacSatDev_misc:RF_SHIELD_BMI_S_201_F_U301
110 | 1 | U401 | RFShield_OnePiece | Not Used | PACSAT_DEV_misc:RF_SHIELD_BOX | PacSatDev_misc:RF_SHIELD_BMI_S_202_F_U401
111 | 1 | U501 | RFShield_OnePiece | Not Used | PACSAT_DEV_misc:RF_SHIELD_BOX | PacSatDev_misc:RF_SHIELD_BMI_S_202_F_U501
112 | 1 | U602 |  | Changed to L710 | Reference_Voltage:LT6657AHMS8-2.5 | Package_SO:MSOP-8_3x3mm_P0.65mm | https://www.analog.com/media/en/technical-documentation/data-sheets/6657fd.pdf
113 | 1 | U604 | RBP-140+ | RBP-140+ | PACSAT_Minicircuits:RBP-140+_1 | RF_Mini-Circuits:Mini-Circuits_GP731
114 | 1 | U652 | CDCLVC1106 | CDCLVC1106PW | PACSAT_ICs:CDCLVP1106 | Package_SO:HTSSOP-14-1EP_4.4x5mm_P0.65mm_EP3.4x5mm_Mask3x3.1mm | https://www.ti.com/lit/ds/symlink/cdclvc1106.pdf?ts=1677547349892
115 | 1 | U701 | RFShield_OnePiece | Not Used | Device:RFShield_OnePiece | PacSatDev_misc:RF_SHIELD_PAD | ~
116 | 1 | U705 | SXBP-425+ | SXBP-425+ | RF_Filter:SXBP-202 | PacSatDev_misc:Mini-Circuits_HF1139_LandPatternPL-230 | https://www.minicircuits.com/pdfs/SXBP-202+.pdf
117 | 1 | Y26 | AB26T-32.768KHZ-6B | AB26T-32.768KHZ-6B | Device:Crystal | Crystal:Crystal_AT310_D3.0mm_L10.0mm_Horizontal | ~
118 | 1 | Y601 | 588S160X2CAT | 588S160X2CAT | Oscillator:FT5HV | PacSatDev_misc:Oscillator_SMD_CTS_4X5mm | https://foxonline.com/wp-content/uploads/pdfs/T5HN_T5HV.pdf
