AMSAT-NA/PacSatDocs/Hardware/Rev_C/PCB/PacSat_Dev_RevC_231018/3D-CAD_Files/ADT4-1WT.STEP

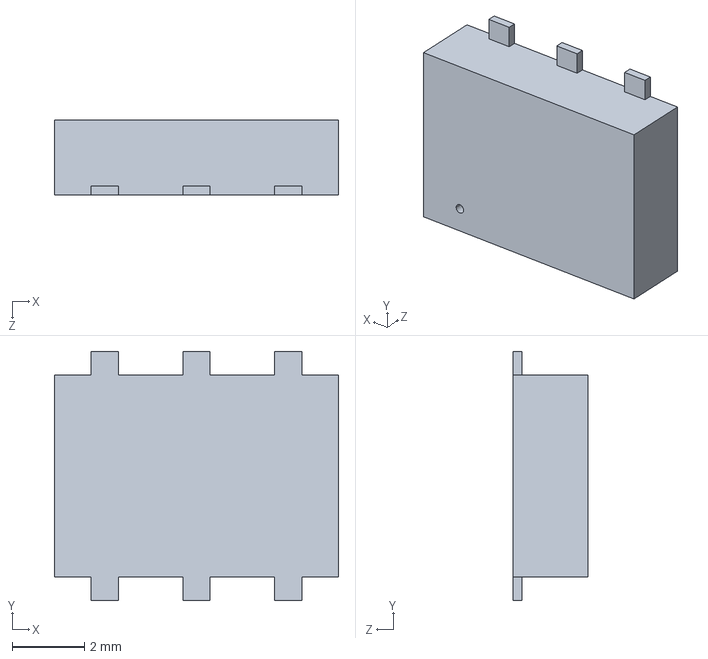
[picture p6: CAD file, 2023-10-24, an earlier design]
Hardware/Rev_C/PCB/PacSat_Dev_RevC_231018/3D-CAD_Files/ADT4-1WT.STEP
7.87 x 6.91 x 2.08 mm
