AMSAT-NA/PacSatDocs/Hardware/Rev_C/PCB/PacSat_Dev_RevC_231018/3D-CAD_Files/SXBP-425.STEP

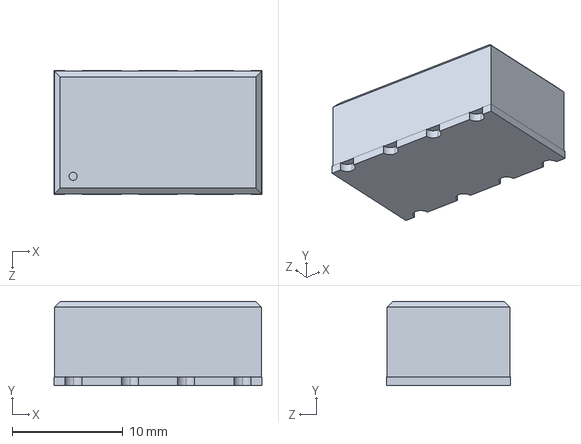
[picture p7: CAD file, 2023-10-24, an earlier design]
Hardware/Rev_C/PCB/PacSat_Dev_RevC_231018/3D-CAD_Files/SXBP-425.STEP
18.8 x 7.62 x 11.2 mm
