AMSAT-NA/PacSatDocs/Hardware/Rev_C/PCB/PacSat_Dev_RevC_231018/3D-CAD_Files/UFL.STEP

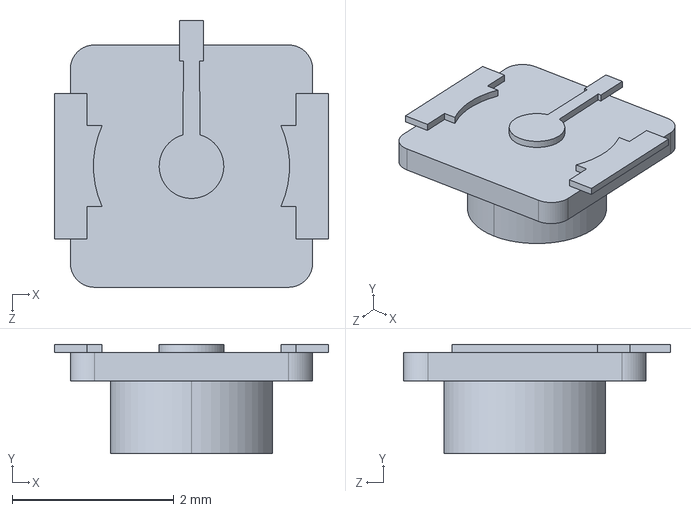
[picture p8: CAD file, 2023-10-24, an earlier design]
Hardware/Rev_C/PCB/PacSat_Dev_RevC_231018/3D-CAD_Files/UFL.STEP
3.39 x 1.35 x 3.30 mm
