AMSAT-NA/PacSatDocs/Hardware/Rev_C/PCB/PacSat_Dev_RevC_231018/3D-CAD_Files/RBP-140.STEP

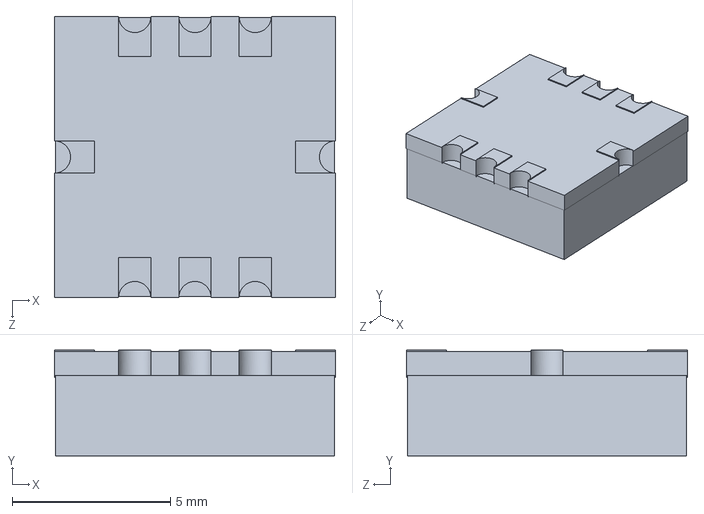
[picture p9: CAD file, 2023-10-24, an earlier design]
Hardware/Rev_C/PCB/PacSat_Dev_RevC_231018/3D-CAD_Files/RBP-140.STEP
8.89 x 3.35 x 8.89 mm
