AMSAT-NA/PacSatDocs/Hardware/Rev_C/PCB/PacSat_Dev_RevC_231018/3D-CAD_Files/Opto_2X1.STEP

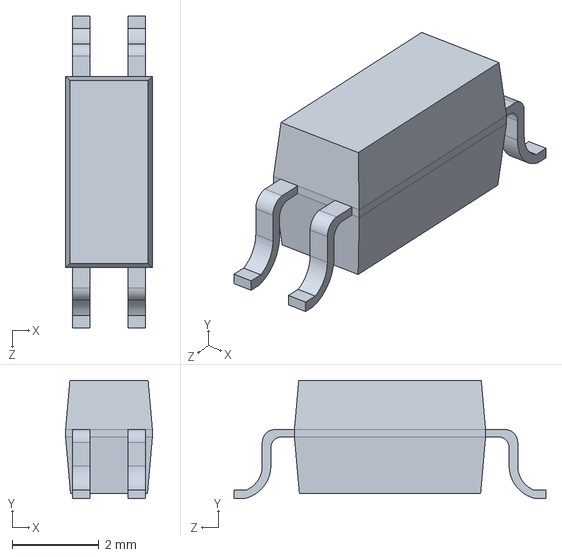
[picture p10: CAD file, 2023-10-24, an earlier design]
Hardware/Rev_C/PCB/PacSat_Dev_RevC_231018/3D-CAD_Files/Opto_2X1.STEP
2.00 x 2.72 x 7.18 mm
