AMSAT-NA/PacSatDocs/Test_Data/1_2_volt_supply_current_modulation_on_+5_inpu.jpg

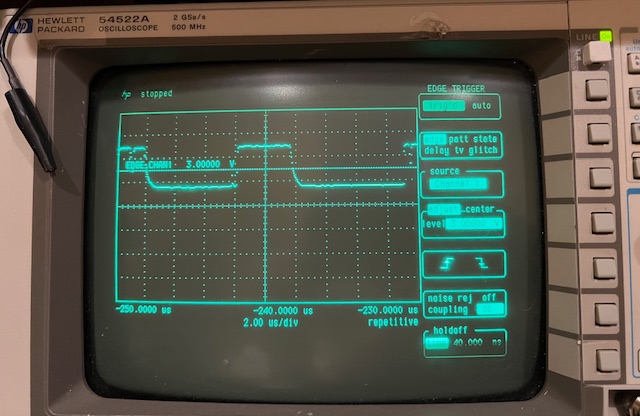
Test_Data/1_2_volt_supply_current_modulation_on_+5_inpu.jpg
