AMSAT-NA/PacSatDocs/Test_Data/3_3_Volt_supply_ripple_and_noise.jpg

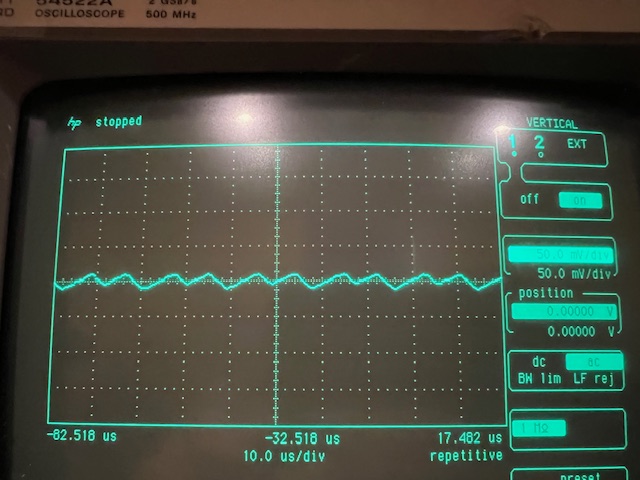
Test_Data/3_3_Volt_supply_ripple_and_noise.jpg
