AMSAT-NA/PacSatDocs/Test_Data/5V_supply_noise.jpg

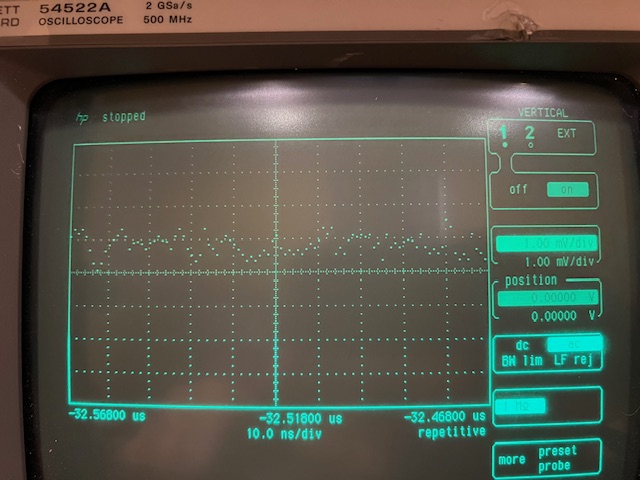
Test_Data/5V_supply_noise.jpg
