AMSAT-NA/PacSatDocs/Test_Data/Port4_N_gain_and_noise_figure_through_RxPreAMP.jpg

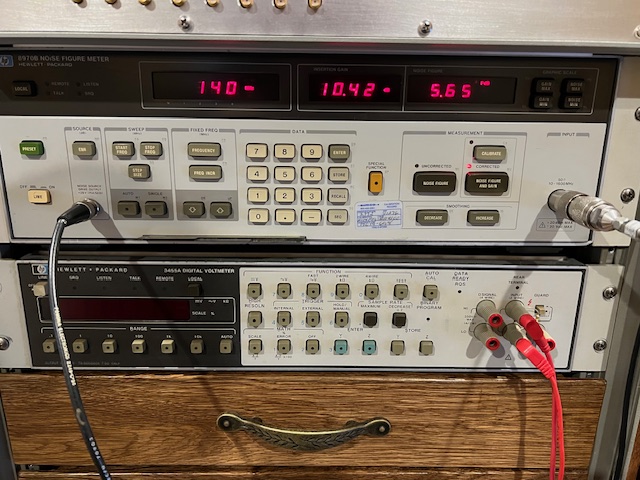
Test_Data/Port4_N_gain_and_noise_figure_through_RxPreAMP.jpg
