AMSAT-NA/PacSatDocs/Test_Data/Port_2_P_with_neg60db_signal_input.jpg

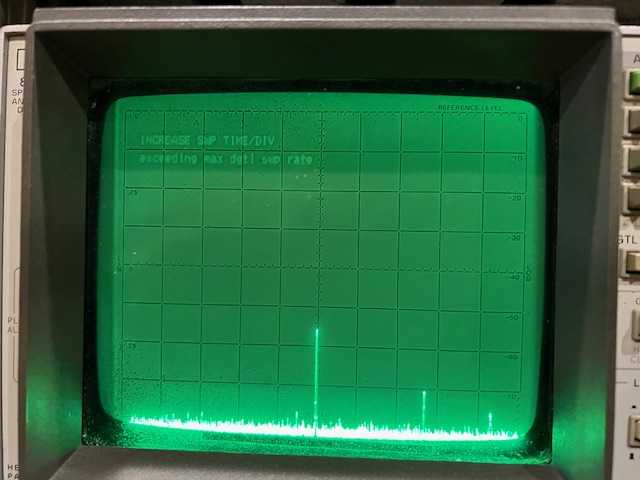
Test_Data/Port_2_P_with_neg60db_signal_input.jpg
