AMSAT-NA/PacSatDocs/Test_Data/Signal_on_receiver_with_no_input_connected_Coming_from_CPU.jpg

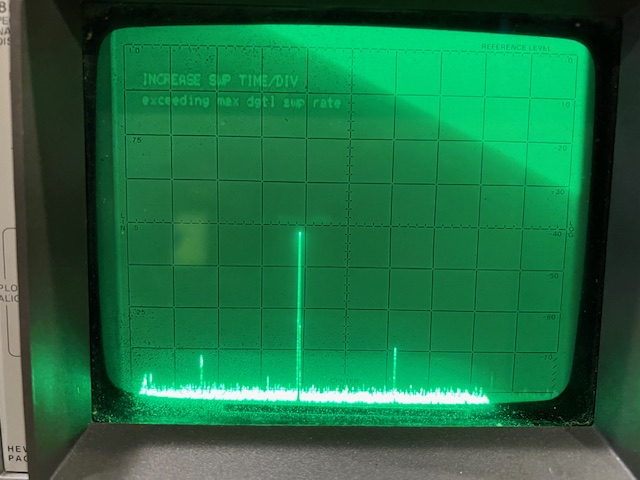
Test_Data/Signal_on_receiver_with_no_input_connected_Coming_from_CPU.jpg
