AMSAT-NA/PacSatDocs/LaunchPad_Daughterboard/ax5043_booster.pdf

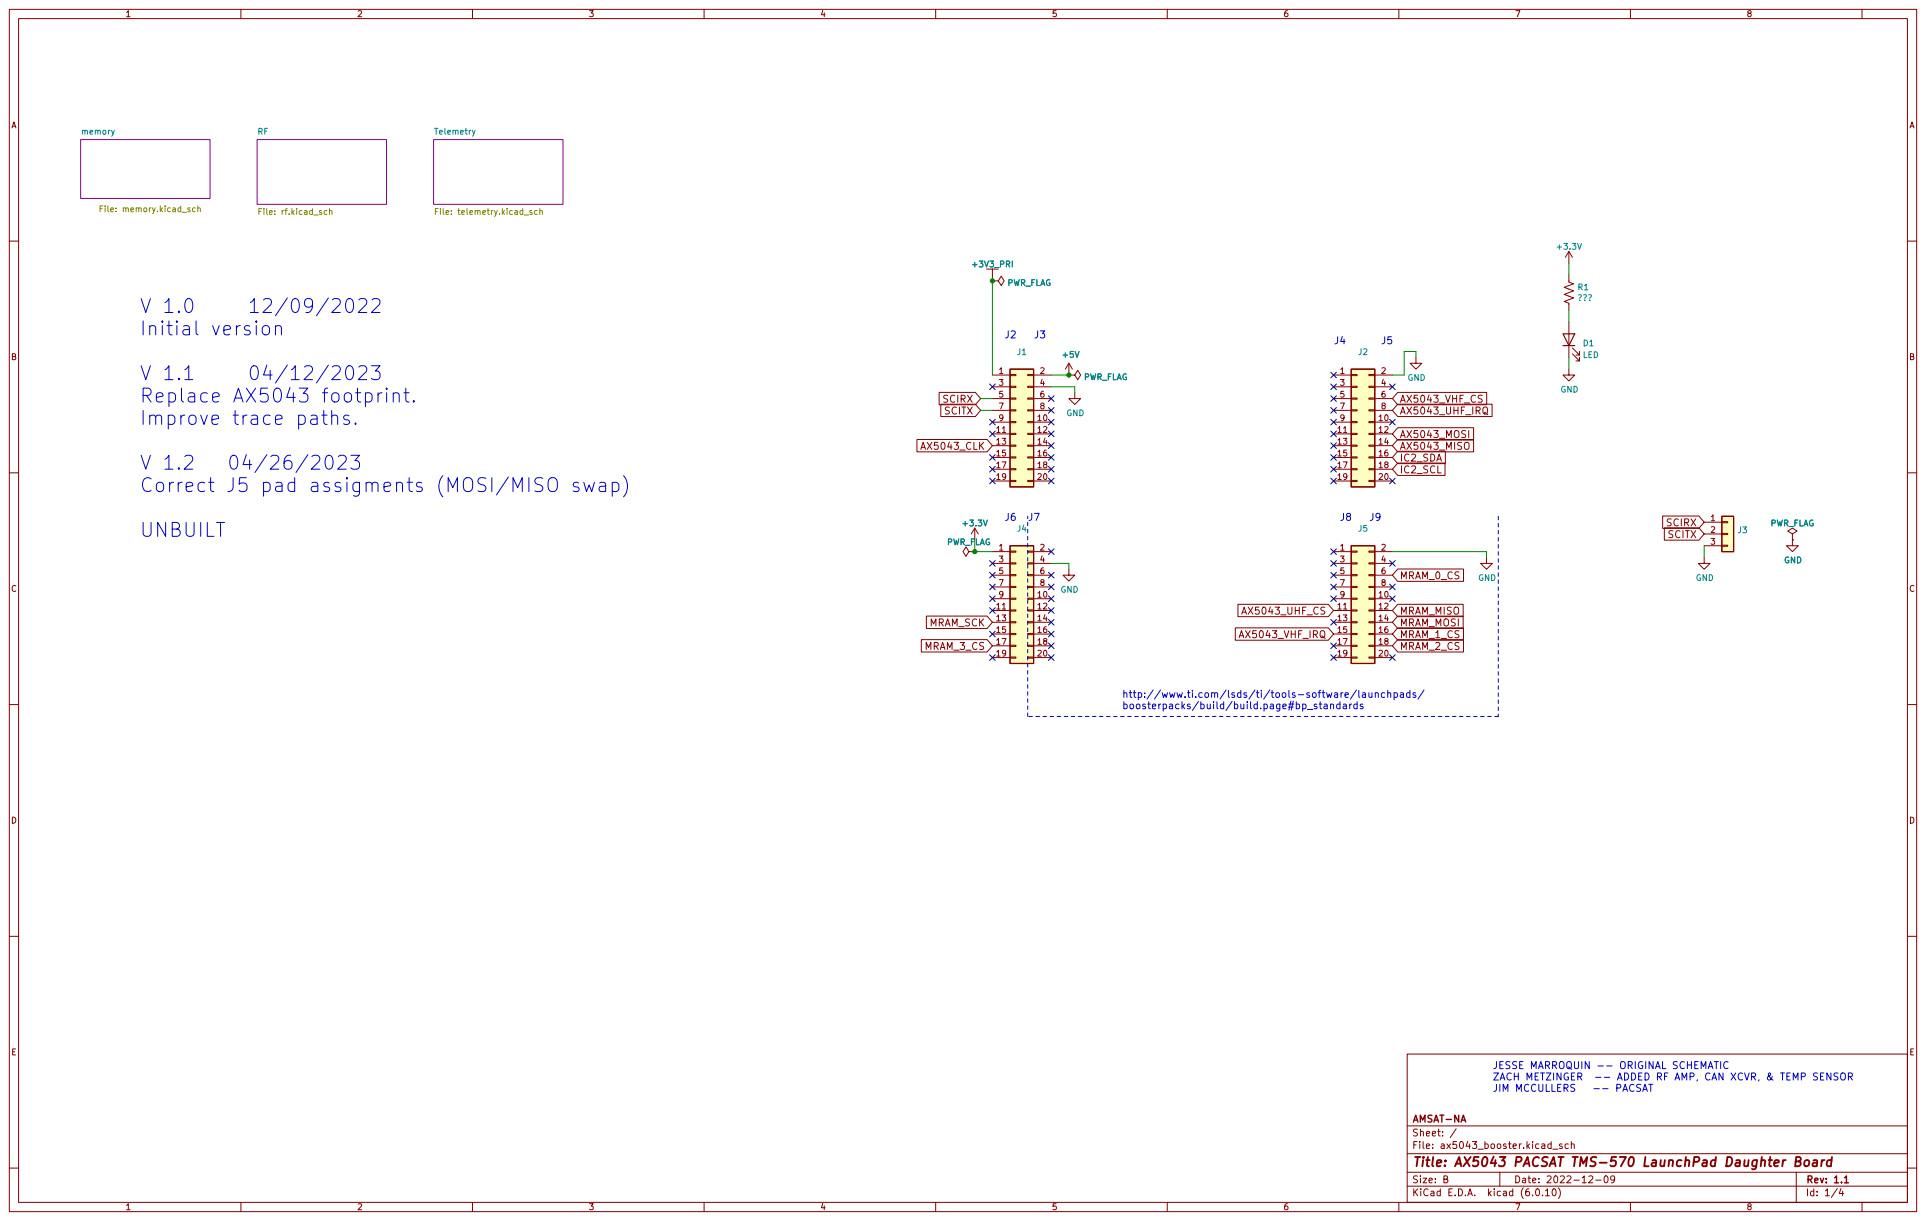
[picture p18: page 1]

File: telemetry.kicad_sch memoryFile: memory.kicad_sch

Correct J5 pad assigments (MOSI/MISO swap)

http://www.ti.com/lsds/ti/tools-software/launchpads/
boosterpacks/build/build.page#bp_standards

JESSE MARROQUIN -- ORIGINAL SCHEMATIC
ZACH METZINGER -- ADDED RF AMP, CAN XCVR, & TEMP SENSOR
JIM MCCULLERS -- PACSAT

File: ax5043_booster.kicad_sch Sheet: / AMSAT-NA

Id: 1/4 Title: AX5043 PACSAT TMS-570 LaunchPad Daughter Board

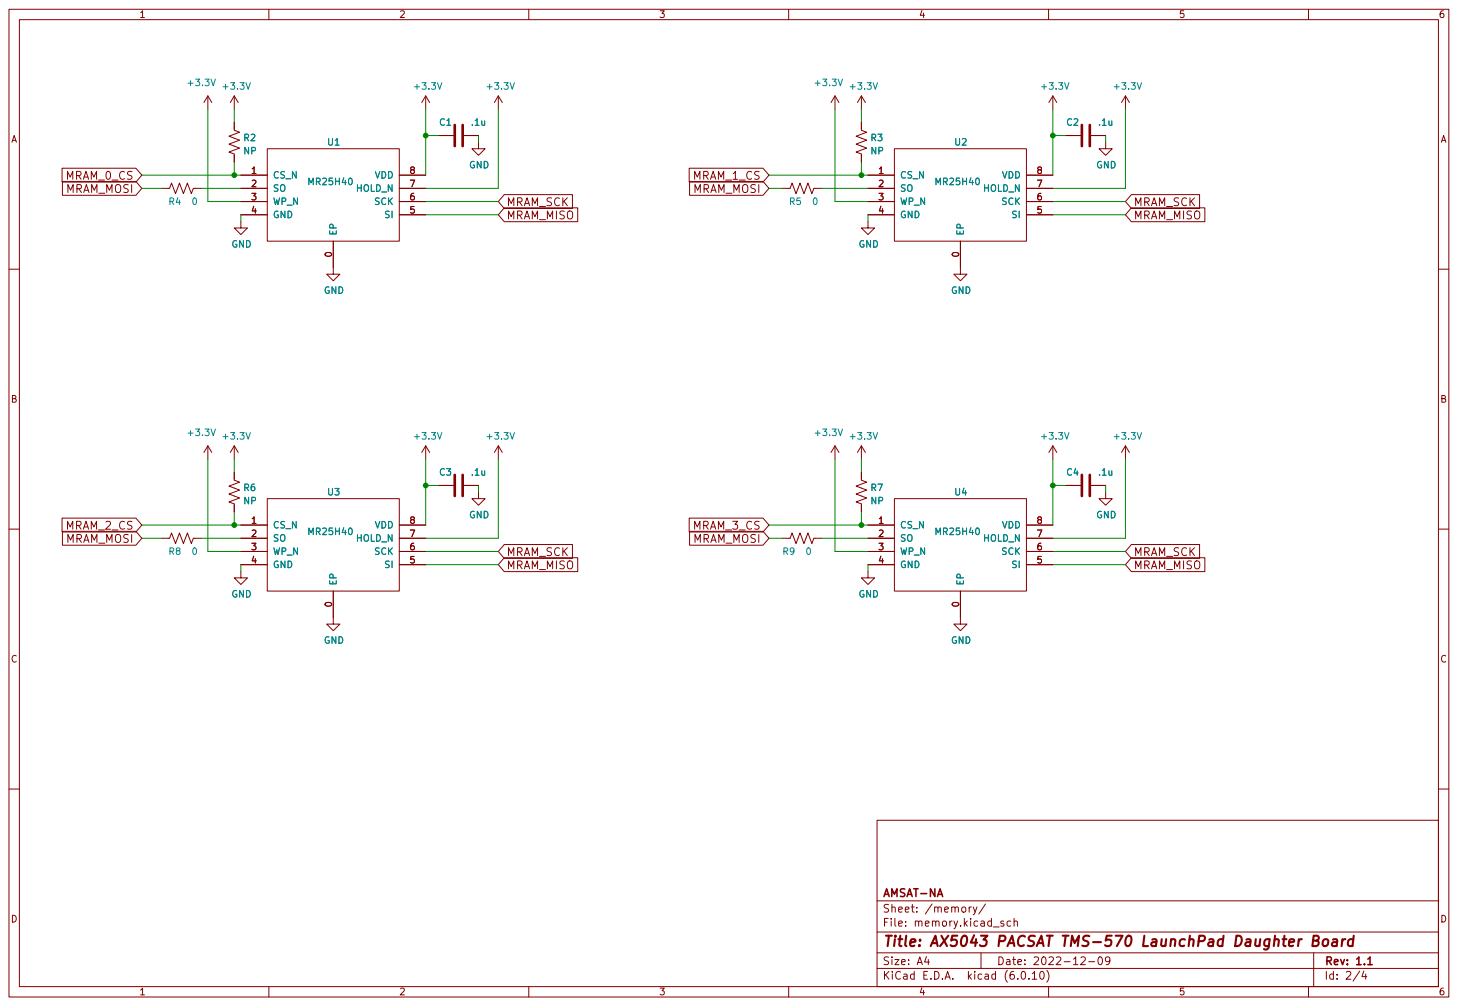
[picture p19: page 2]

0 CS_N 1 SO 2 WP_N 3 GND 4 SI 5 SCK 6 HOLD_N 7 VDD 8 U1 MR25H40 GND GND GND EP

0 CS_N 1 SO 2 WP_N 3 GND 4 SI 5 SCK 6 HOLD_N 7 VDD 8 U2 MR25H40 GND

0 CS_N 1 SO 2 WP_N 3 GND 4 SI 5 SCK 6 HOLD_N 7 VDD 8 GND GND GND

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

0 CS_N 1 SO 2 WP_N 3 GND 4 SI 5 SCK 6 HOLD_N 7 VDD 8 U4 MR25H40 +3.3V C4 .1u GND

0 CS_N 1 SO 2 WP_N 3 GND 4 SI 5 SCK 6 HOLD_N 7 VDD 8 U3 MR25H40 GND

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

Sheet: /memory/ AMSAT-NA

File: memory.kicad_sch
Id: 2/4 Title: AX5043 PACSAT TMS-570 LaunchPad Daughter Board

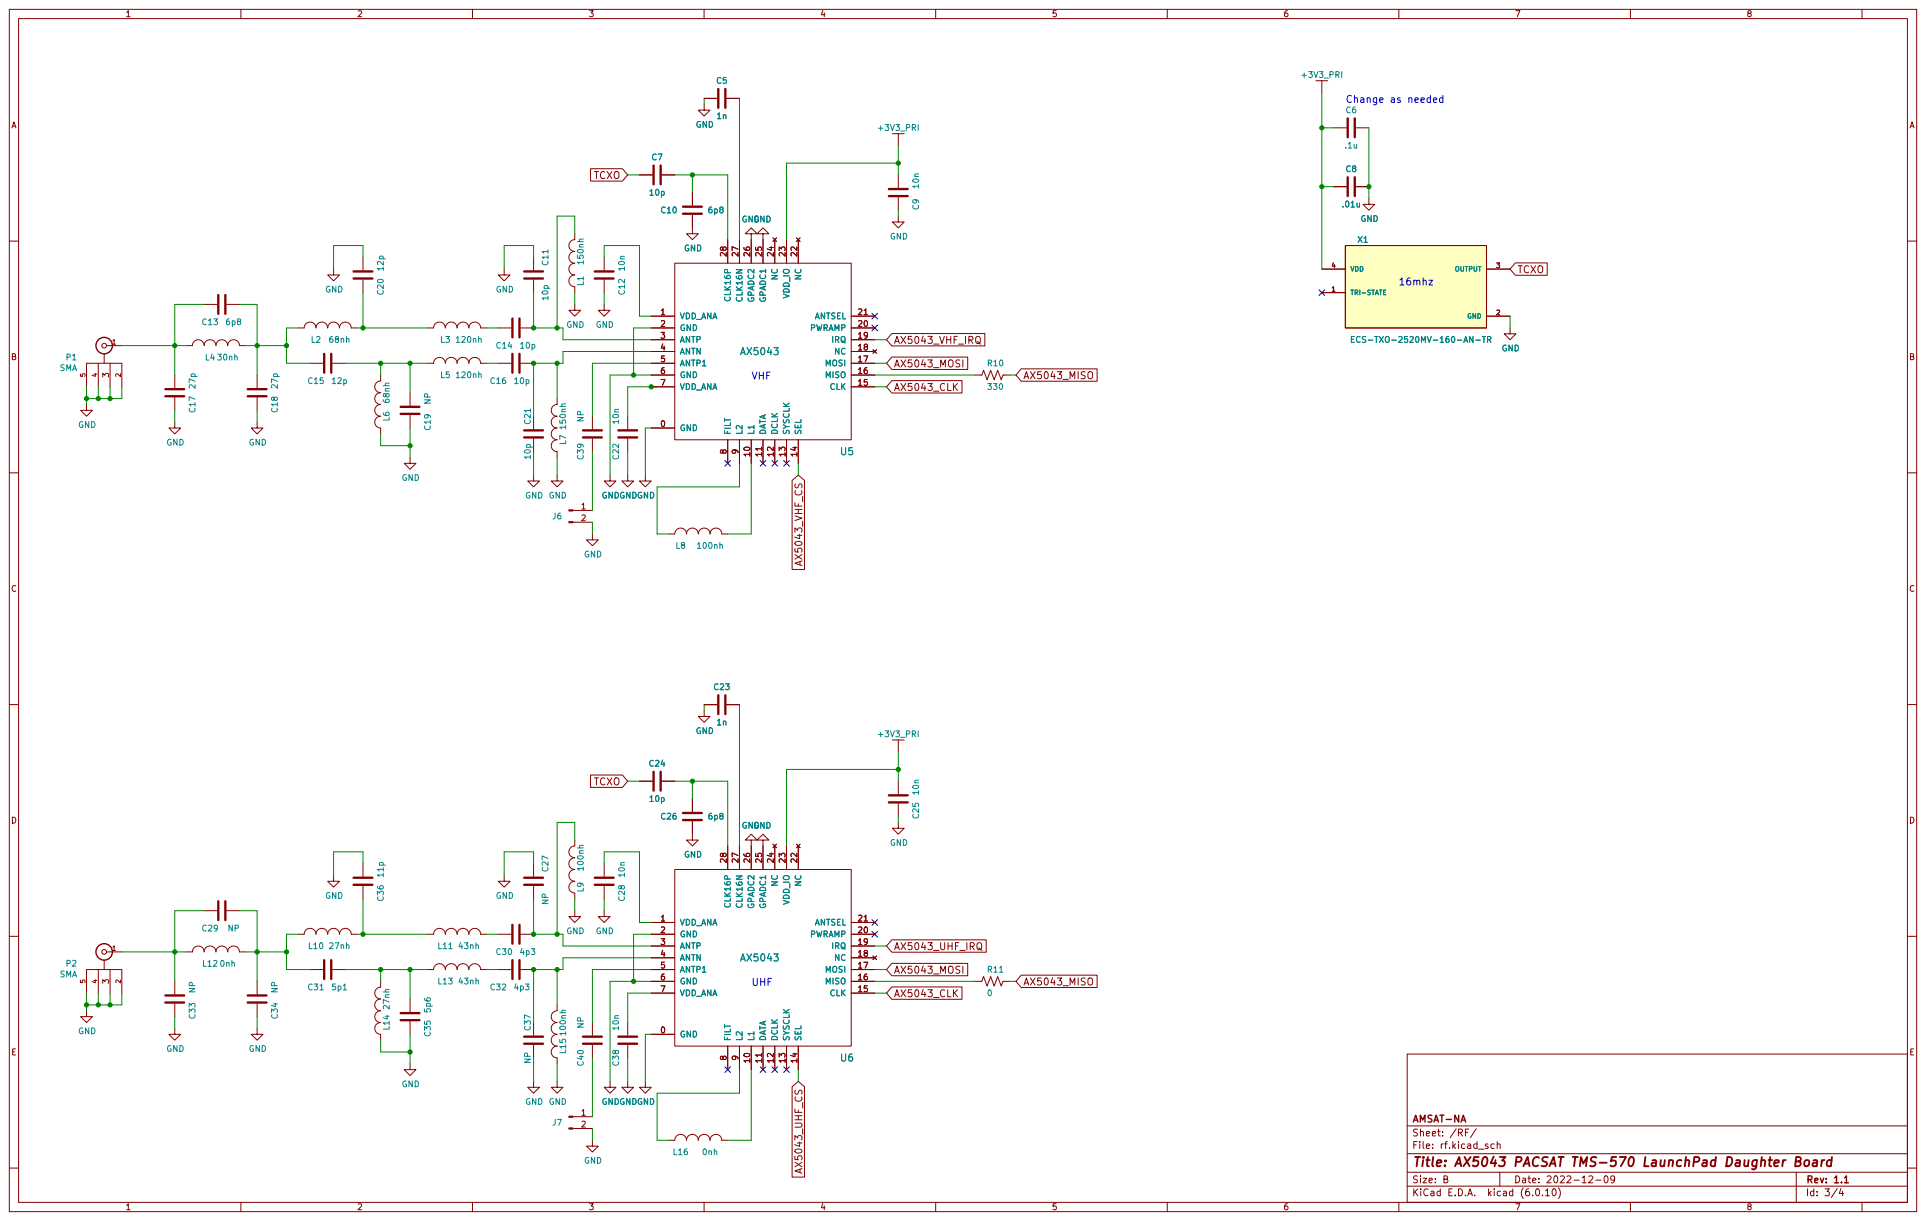
[picture p20: page 3]

File: rf.kicad_sch Sheet: /RF/ AMSAT-NA

Id: 3/4 Title: AX5043 PACSAT TMS-570 LaunchPad Daughter Board

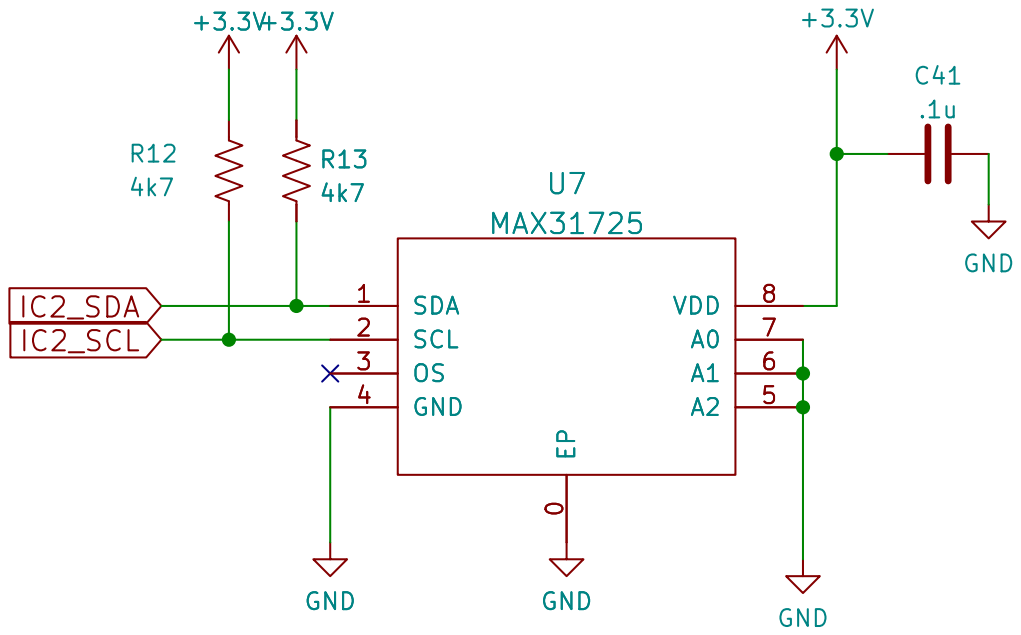
[picture p21: page 4]

0 SDA 1 SCL 2 OS 3 GND 4 A2 5 A1 6 A0 7 VDD 8 U7 MAX31725 GND GND

0 SDA 1 SCL 2 OS 3 GND 4 A2 5 A1 6 A0 7 VDD 8 GND GND

Sheet: /Telemetry/ AMSAT-NA

File: telemetry.kicad_sch
Id: 4/4 Title: AX5043 PACSAT TMS-570 LaunchPad Daughter Board
