AMSAT-NA/PacSatDocs/requirements/Pacsat-rtos-software-architecture.pdf

# PACSAT RTOS Software Architecture

### By: Chris Thompson G0KLA, Burns Fisher WB1FJ

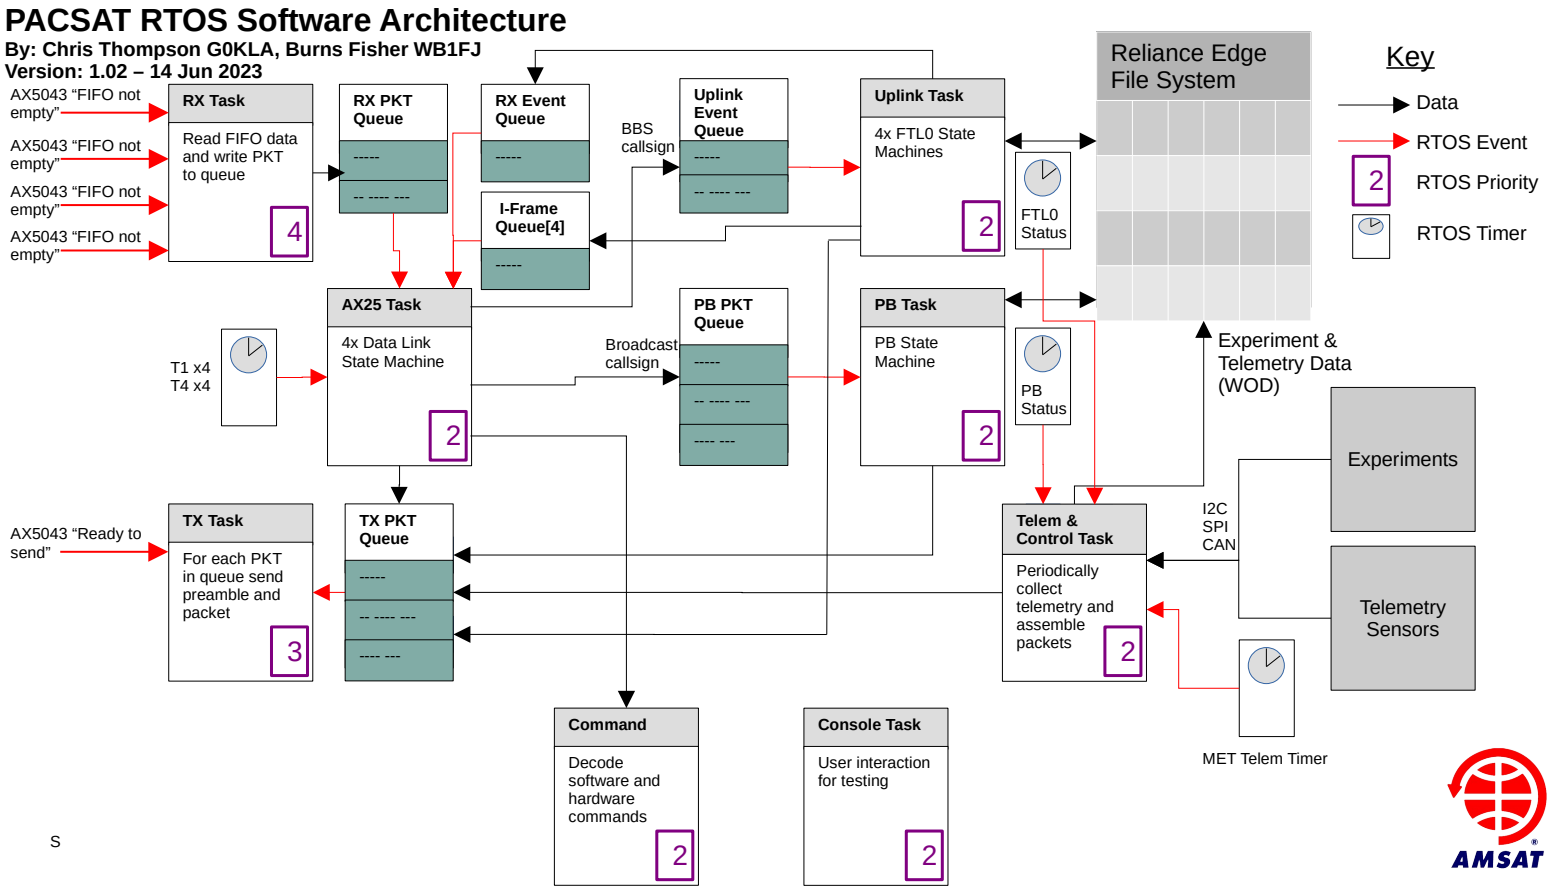
[picture p22: page 1]
Version: 1.02 – 14 Jun 2023; RX Task; RX PKT; Queue; TX Task; PB PKT; AX25 Task; 4x Data Link; State Machine; PB Task; PB State; Machine; Command; Decode; software and; hardware; commands; Console Task; User interaction; for testing; Uplink; Event; AX5043 “FIFO not; empty”; TX PKT; Uplink Task; 4x FTL0 State; Machines; Key; Data; RTOS Event; Reliance Edge; File System; Experiment &; Telemetry Data; (WOD); BBS; callsign; Broadcast; Telem; Control; Task; Periodically; collect; telemetry and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

Read FIFO data
and write PKT
to queue

For each PKT
in queue send
preamble and
packet

MET Telem Timer
