AMSAT-NA/PacSatDocs/Hardware/Rev_C/PCB/PacSat_Dev_RevC_231018/PacSatPCB_Rev_A.PDF

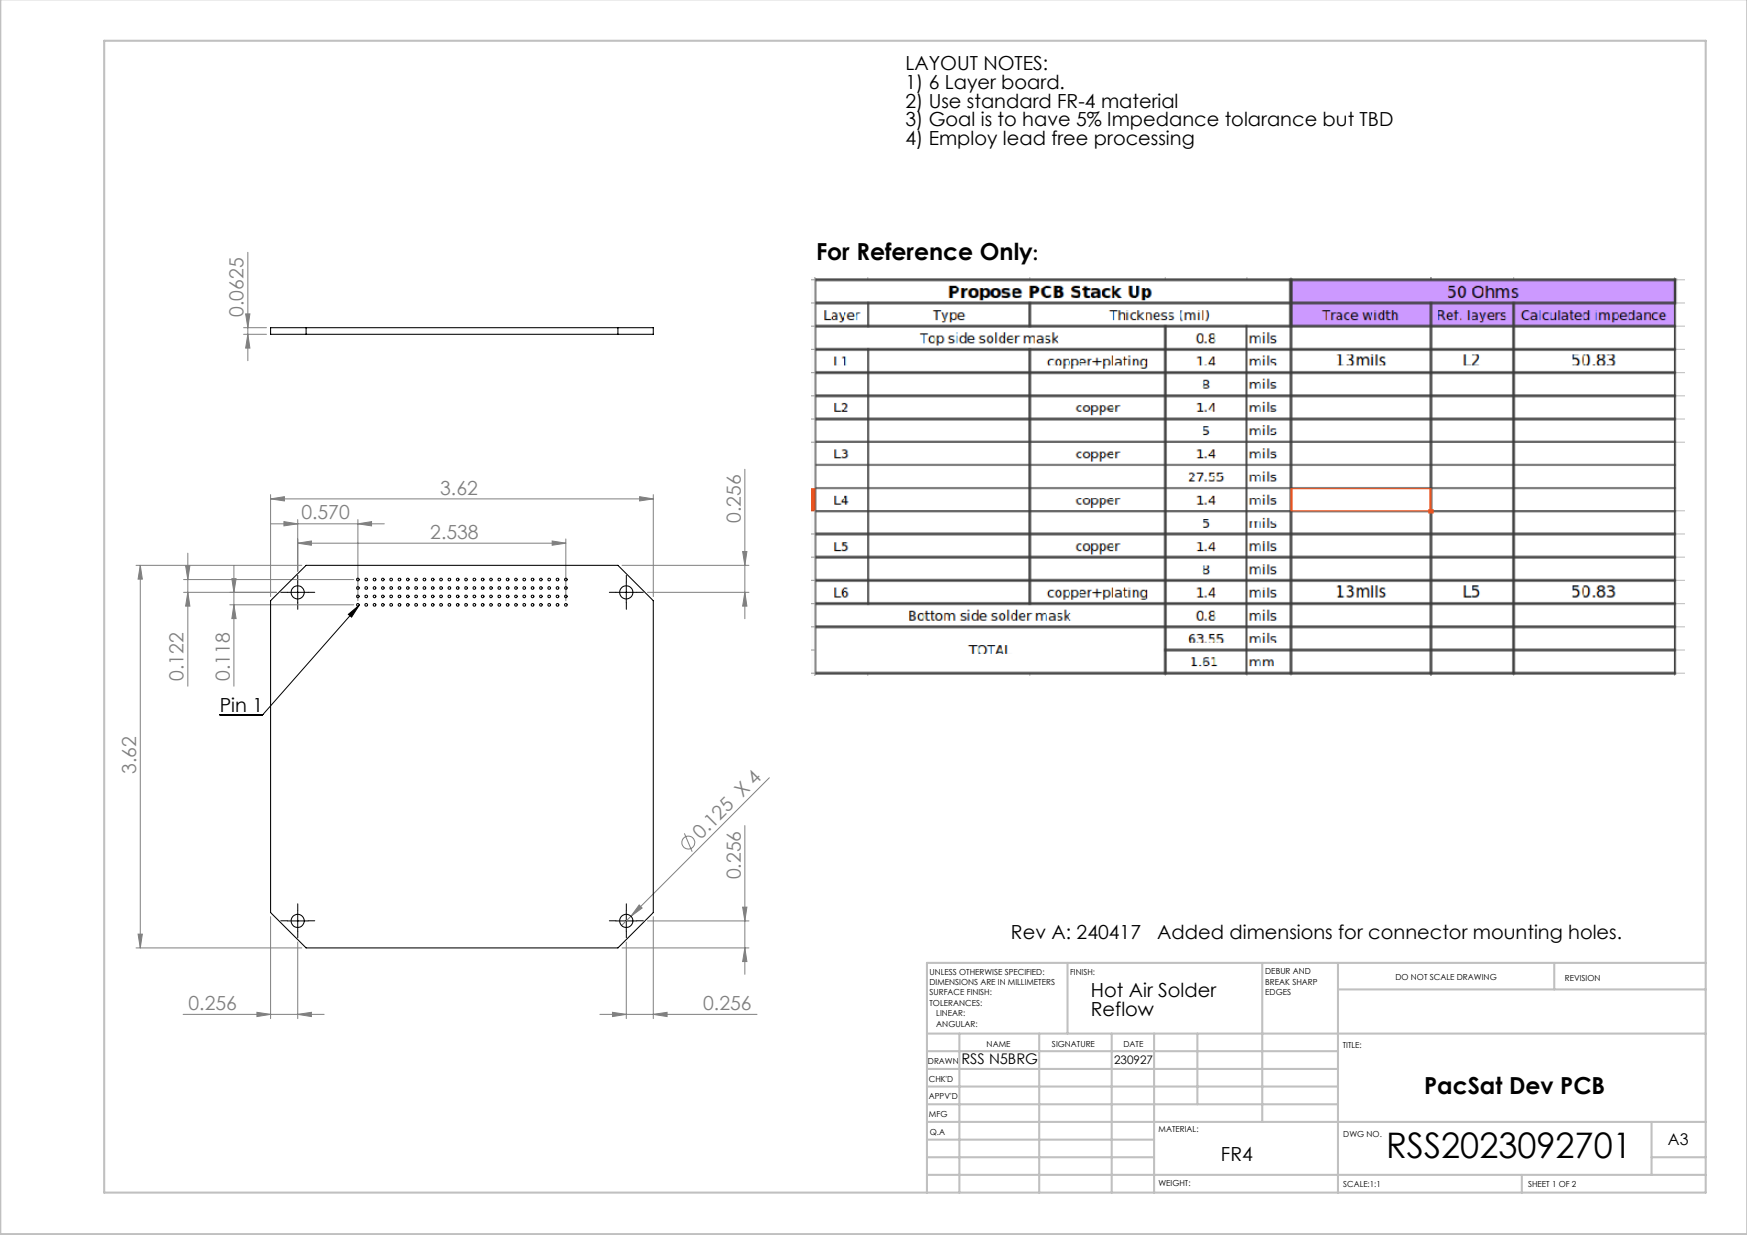
[picture p23: page 1]
Pin 1 0.0625; SCALE:1:1; SHEET 1 OF 2; DO NOT SCALE DRAWING; REVISION; DEBUR AND BREAK SHARP; UNLESS OTHERWISE SPECIFIED:; FINISH:

LAYOUT NOTES:
1) 6 Layer board.
2) Use standard FR-4 material
3) Goal is to have 5% Impedance tolarance but TBD
4) Employ lead free processing

For Reference Only:

Rev A: 240417 Added dimensions for connector mounting holes.

DIMENSIONS ARE IN MILLIMETERS
SURFACE FINISH:
TOLERANCES:
LINEAR:
ANGULAR:

Hot Air Solder
Reflow

NAME | SIGNATURE | DATE | | | | TITLE: PacSat Dev PCB
Q.A | | | | MATERIAL: FR4 | RSS2023092701 WEIGHT: DWG NO. | A3

DRAWN | RSS N5BRG | | 230927

CHK'D
APPV'D
MFG

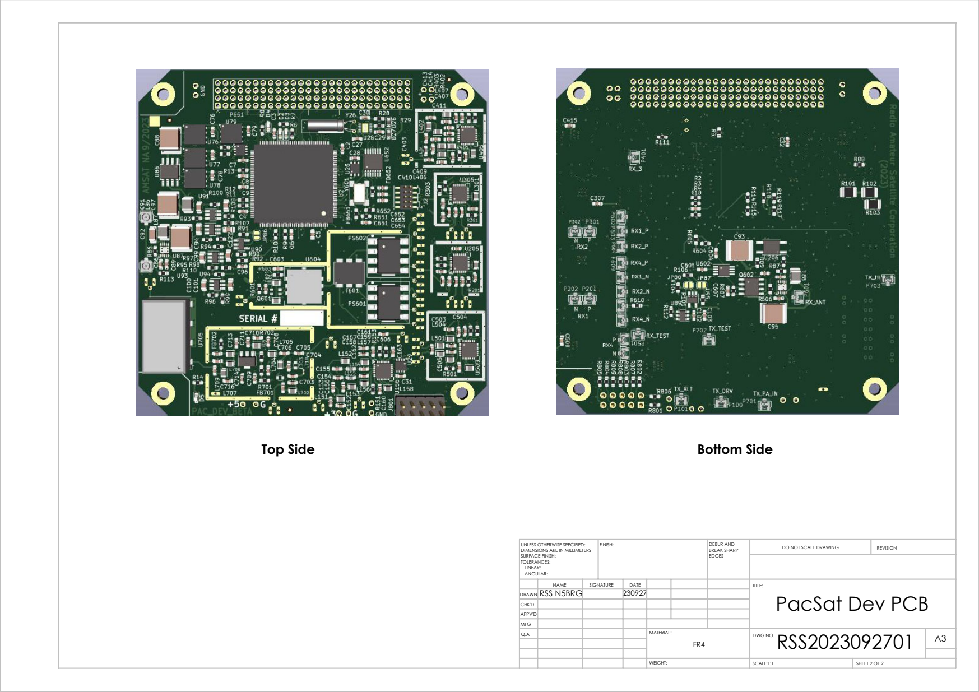
[picture p24: page 2]
Top Side; Bottom Side; SCALE:1:1; SHEET 2 OF 2; DO NOT SCALE DRAWING; REVISION; DEBUR AND BREAK SHARP; UNLESS OTHERWISE SPECIFIED:; FINISH:

DIMENSIONS ARE IN MILLIMETERS
SURFACE FINISH:
TOLERANCES:
LINEAR:
ANGULAR:

NAME | SIGNATURE | DATE | TITLE:
DRAWN | | | 230927 | PacSat Dev PCB RSS N5BRG
Q.A | MATERIAL: FR4 | RSS2023092701 WEIGHT: DWG NO. | A3

CHK'D
APPV'D
MFG
