AMSAT-NA/PacSatDocs/Hardware/Rev_C/PCB/PCB_JTAG_REVA.pdf

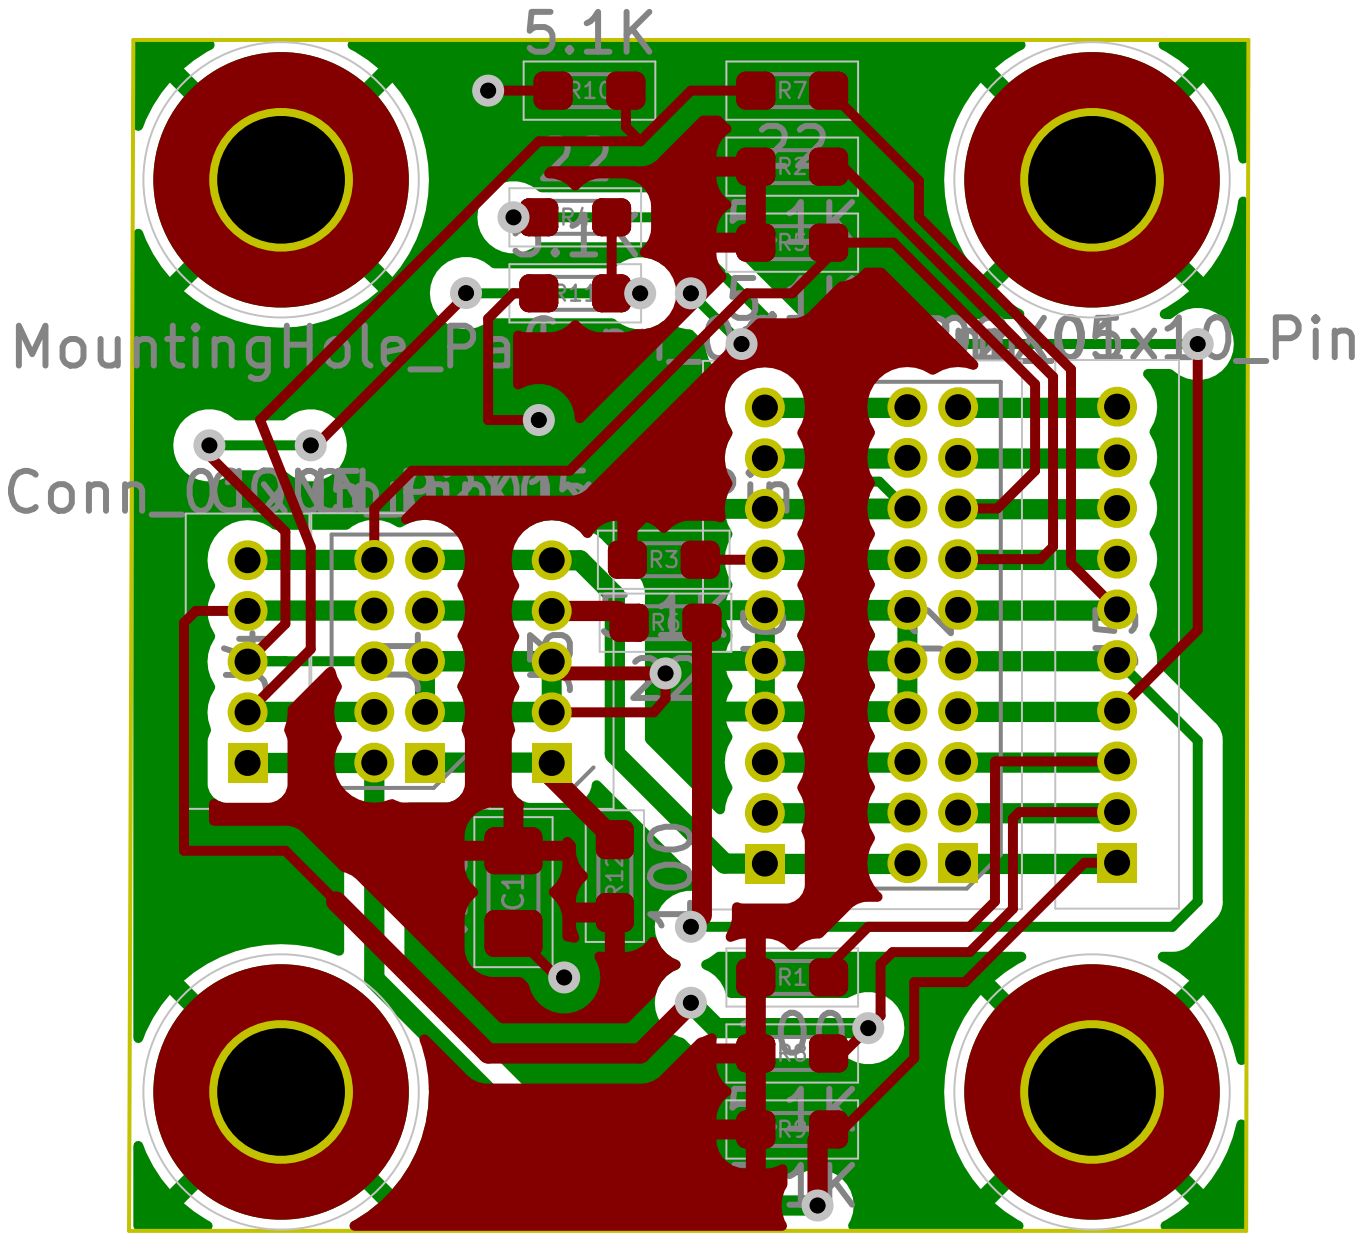
[picture p25: page 1]
