AMSAT-NA/PacSatDocs/Hardware/Rev_C/Schematics/Schematic_JTAG_RevA.pdf

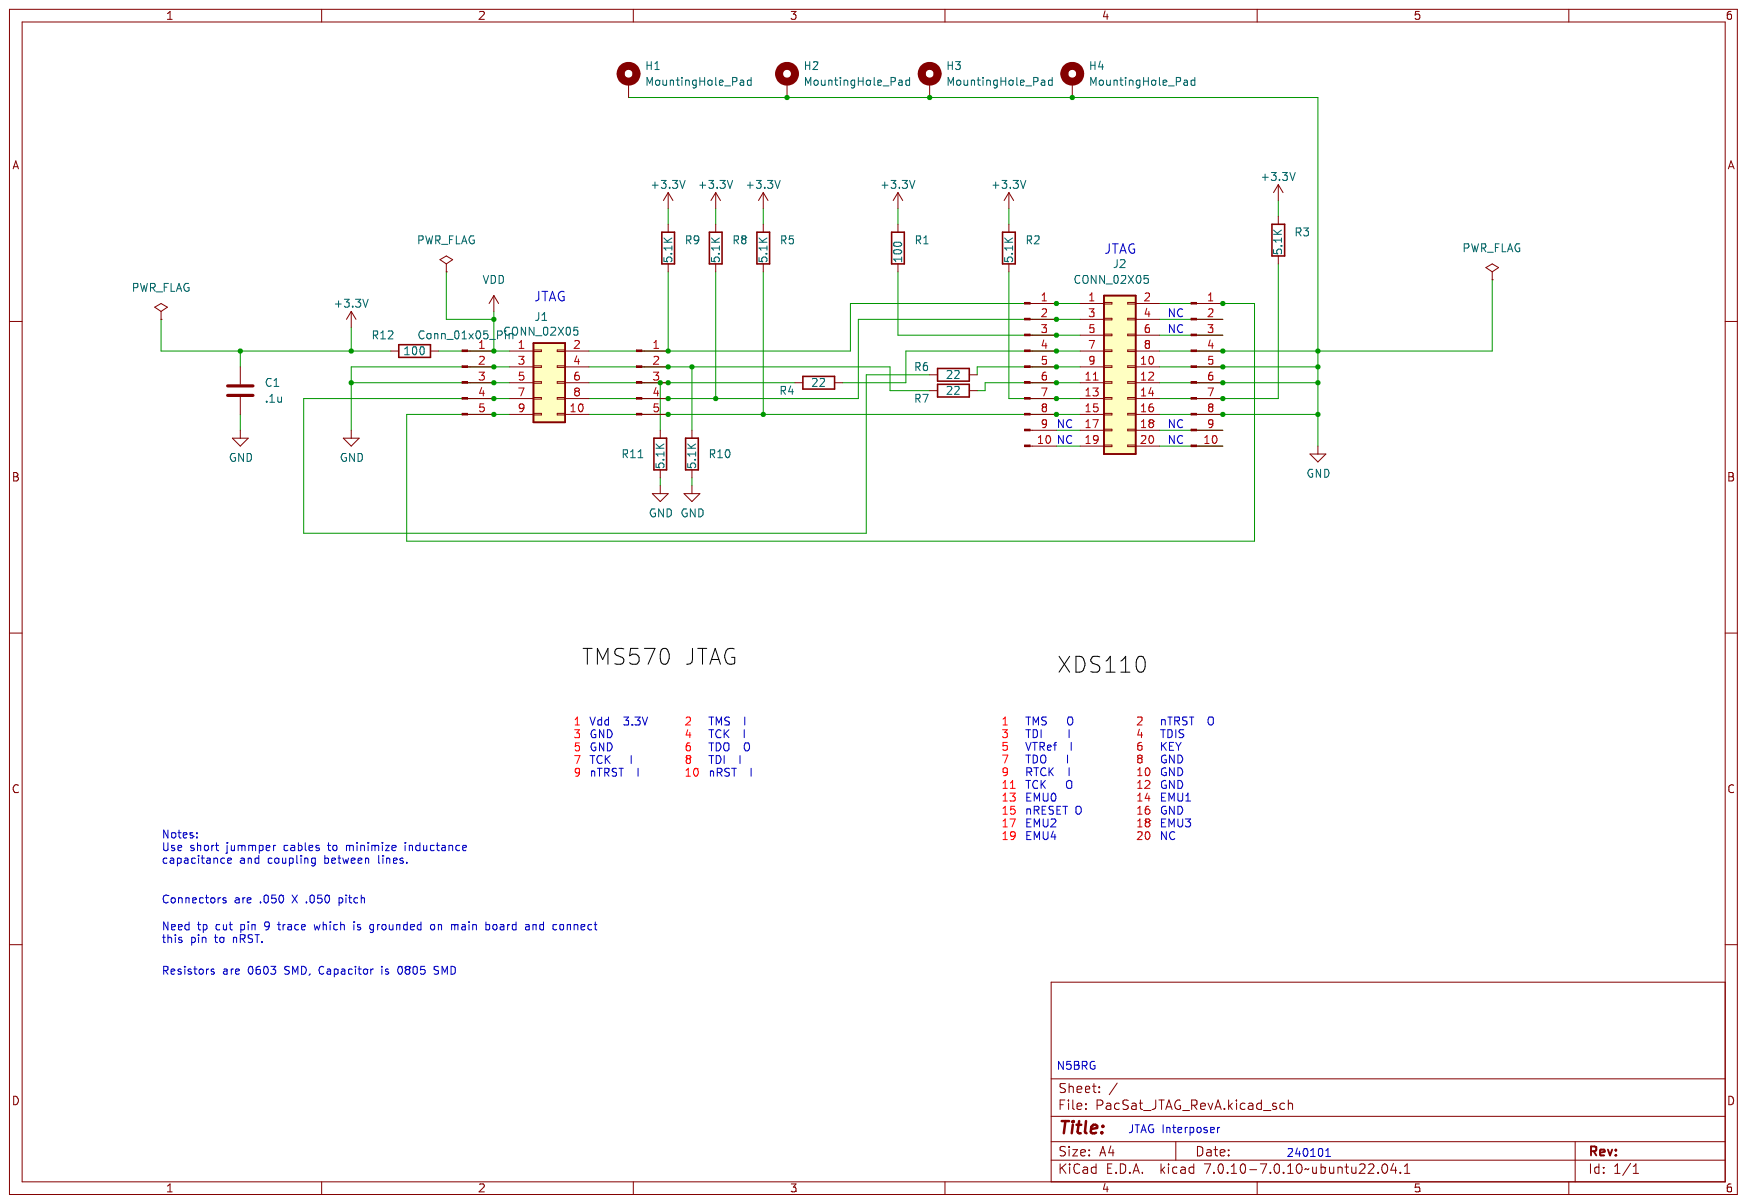
[picture p26: page 1]
