AMSAT-NA/PacSatDocs/Hardware/Rev_C/PCB/LED_Pad_Compair.PDF

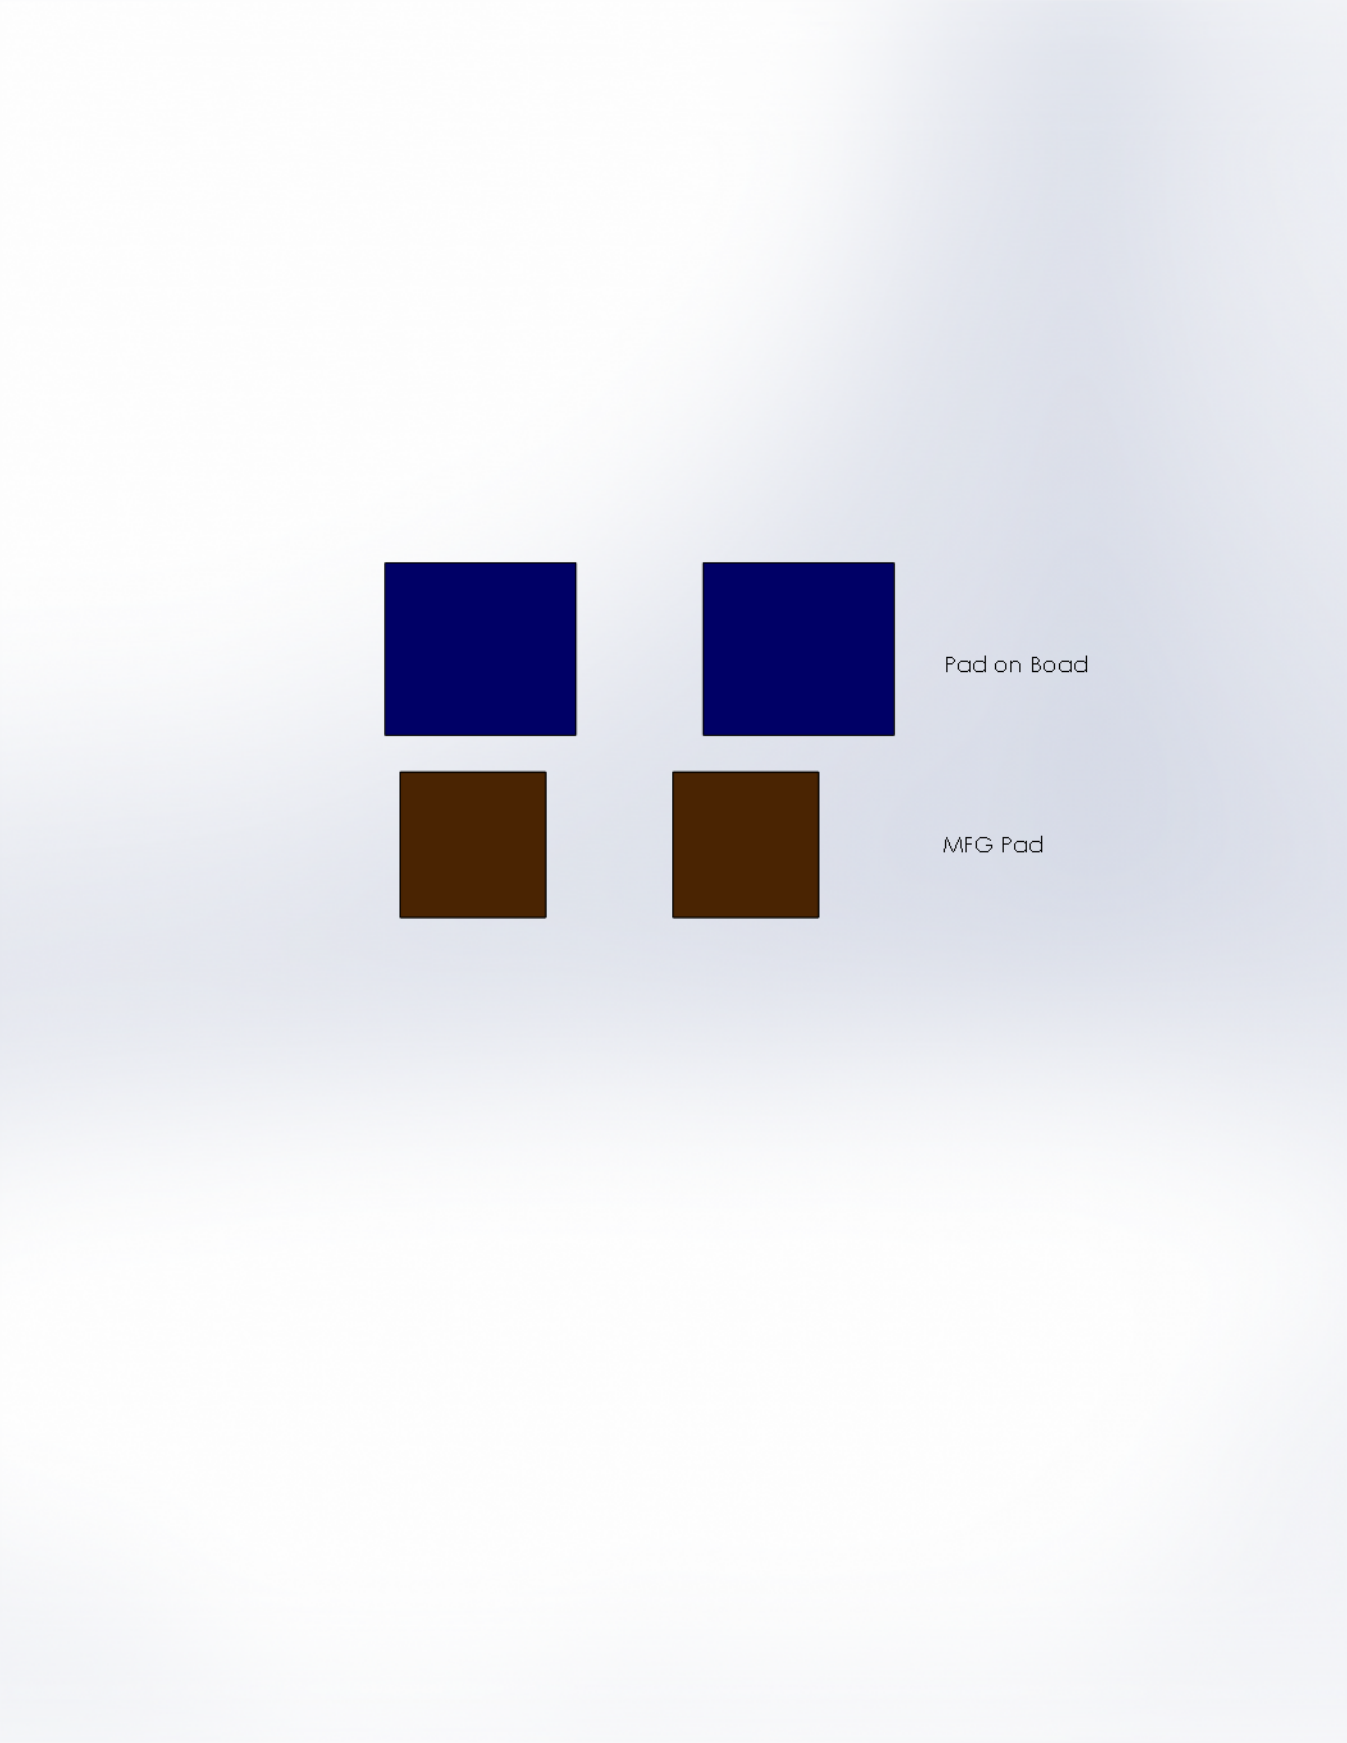
[picture p27: page 1]
