AMSAT-NA/PacSatDocs/(commit log)

2022-11-13 Add rt-ihu design files for reference
    [arbiter.sch, primary_ax5043.sch, primary_comm_mem.sch, primary_power.sch, primary_tms570.sch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]
2022-11-26 Created pacsat-memory-model
    [pacsat-memory-model.ods]
2023-02-21 Add flight software and driver docs from Golf
2023-03-19 Added Burns launch pad headers doc with outside connector alternatives
    [LaunchPad_Headers.ods]
2023-03-25 Create Hardware folder and Schematic Folder for designs of test boards and the CubSatPacSat board and included Alpha_Rev4 schematic of CubeSatPacSat
2023-04-28 Add some text that I emails to Chris about interrupts
2023-05-09 Create kicad
2023-07-20 Initial telemetry layouts
    [DownlinkSpecPacsat.xlsx]
2023-07-21 Add CubeSpace ADCS pins to spreadsheet
    [pinouts.ods]
2023-08-19 Show I2C on J11
    [LaunchPad_Headers.ods]
2023-08-30 Pushing up current KiCad files with schmatic and PCB layout. Still more corrections to make. Includes PDF version of each
2023-09-06 Update to KiCad files with schmatic and PCB layout. All Inspections are clean. Need to double check pads for ICs and Pinout pads. I have dimensions fo all pads ready to do this. The standard KiCad li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
    [AX5043_RX.kicad_pcb, AX5043_RX.kicad_sch, BUS_IO_Interface.kicad_sch, Clocks.kicad_sch, PC104_io_conn.kicad_sch, PacSat_Dev_RevC_230824.csv, PacSat_Dev_RevC_230824.kicad_pcb, PacSat_Dev_RevC_230824.kicad_sch]
2023-09-07 PCB updates correcting two footprints on PCB and adding test connections and structures.
    [AX5043_RX.kicad_pcb, AX5043_RX.kicad_sch, BUS_IO_Interface.kicad_sch, Clocks.kicad_sch, PC104_io_conn.kicad_sch, PacSat_Dev_RevC_230905.csv, PacSat_Dev_RevC_230905.kicad_pcb, PacSat_Dev_RevC_230905.kicad_sch]
2023-09-09 Added parts to force shutdown of transmitter when processor not working. Changed some designations for parts. Adjusted AX5043 footprint.
    [AX5043_RX.kicad_pcb, AX5043_RX.kicad_sch, BUS_IO_Interface.kicad_sch, Clocks.kicad_sch, PC104_io_conn.kicad_sch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]
2023-09-10 Added fresh PDF of schematic and PCB. Added BOM .
    [BOM.ods]
2023-09-10 Changed schematic to add Select lines for each AX5043 on the CPU.
2023-09-14 Made changes to PCB and Schematic per Errata. Added a gerber.zip file to putput to fab house.
2023-09-15 Added A/D connections to positive supplies and updated all related files. Now gerber.zip created.
    [AX5043_RX.kicad_pcb, AX5043_RX.kicad_sch, BUS_IO_Interface.kicad_sch, Clocks.kicad_sch, PC104_io_conn.kicad_sch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]
2023-10-06 More last minute cleanup on PCB. Added a second crystal footprint to PCB to support alternate vendor.
    [AX5043_RX.kicad_pcb, AX5043_RX.kicad_sch, BUS_IO_Interface.kicad_sch, Clocks.kicad_sch, PC104_io_conn.kicad_sch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]
2023-10-06 Moved schematic to proper folder and updated errata
2023-10-07 Updated telem definition
    [DownlinkSpecPacsat.xlsx]
2023-10-07 git ignore .h files in telem definition
    [DownlinkSpecPacsat.csv]
2023-10-24 Updated PCB files after fixing issues with footprints and updated errata
    [ADT4-1WT.STEP, AX5043_RX.kicad_pcb, AX5043_RX.kicad_sch, BUS_IO_Interface.kicad_sch, Clocks.kicad_sch, Opto_2X1.STEP, PC104_io_conn.kicad_sch, PacSat_1-1_check.xlsx]
2024-01-04 Added information on JTAG REV A board
    [PacSat_CPU_Pin_Assignment.ods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]
2024-01-29 Added a folder for Test data and an updated Box 3D mold design.
2024-02-23 Updated with Rev D changes which includes most of the modifications made on the prototype Rev_C boards. Also includes changes needed for next layout of PCB. No work done on a Rev D PCB yet. Added bot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
    [AX5043_RX.kicad_pcb, AX5043_RX.kicad_sch, BUS_IO_Interface.kicad_sch, Clocks.kicad_sch, PC104_io_conn.kicad_sch, PacSat_Dev_RevC_231011.kicad_pcb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]
2024-03-13 Updated PacSat Rev D files under Hardware PCB
    [BUS_IO_Interface.kicad_sch, Clocks.kicad_sch, PC104_io_conn.kicad_sch, PacSat_Dev_RevD_240223.kicad_sch, Power_Amp.kicad_sch, Power_Divider.kicad_sch, RPi UPS.kicad_pcb, RPi UPS.kicad_sch]
2024-04-17 Revised the PCB mechanical drawing to Rev A so as to include 104 pin connector location.
2024-05-22 Revised the RevD schematic to show know changes. This is not complete but does move closer to the desired PCB.
    [AX5043_RX.kicad_pcb, AX5043_RX.kicad_sch, BUS_IO_Interface.kicad_sch, Clocks.kicad_sch, PC104_io_conn.kicad_sch, PacSat_Dev_RevC_231011.kicad_pcb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]
2024-06-14 Working to cleanup director folder for Hardware and consolidate files between Rev_c and Rev_D. Rev_D folder also contains ohter project nformation files.
    [ADT4-1WT.STEP, AX5043_RX.kicad_pcb, AX5043_RX.kicad_sch, BUS_IO_Interface.kicad_sch, Clocks.kicad_sch, Opto_2X1.STEP, PC104_io_conn.kicad_sch, PacSat_1-1_check.xlsx]
2026-03-09 PACSAT layouts updated to use new C structs. Lots of work to do, but this framework is operational with the ground station. errors split into seperate payloads.
    [DownlinkSpecPacsat.csv, DownlinkSpecPacsat.xlsx, PACSAT_errtelemetry.csv, PACSAT_errwodtelemetry.csv, PACSAT_rttelemetry.csv, PACSAT_wodtelemetry.csv]
2026-03-09 Updated telem values
    [DownlinkSpecPacsat.csv, DownlinkSpecPacsat.xlsx, PACSAT_rttelemetry.csv, PACSAT_wodtelemetry.csv]
2026-03-10 Small changes to layouts
    [DownlinkSpecPacsat.xlsx]
2026-03-13 Ongoing changes for V2 board
    [DownlinkSpecPacsat.csv, DownlinkSpecPacsat.xlsx, PACSAT_errtelemetry.csv, PACSAT_errwodtelemetry.csv, PACSAT_rttelemetry.csv, PACSAT_wodtelemetry.csv]
2026-03-24 Lastest layouts
    [DownlinkSpecPacsat.csv, DownlinkSpecPacsat.xlsx, PACSAT_errtelemetry.csv, PACSAT_errwodtelemetry.csv, PACSAT_rttelemetry.csv, PACSAT_wodtelemetry.csv]
2026-03-26 Drafted error handling analysis sheet
    [error_handling_and_downlink.ods]
2026-03-30 Changes to support better error handling and reporting
    [DownlinkSpecPacsat.csv, DownlinkSpecPacsat.xlsx, error_handling_and_downlink.ods]
2026-03-30 Fix issue with pad0 line
    [DownlinkSpecPacsat.csv, DownlinkSpecPacsat.xlsx]
2026-03-30 Fix layout issue for ground station
    [DownlinkSpecPacsat.csv, DownlinkSpecPacsat.xlsx]
2026-03-30 Fix small layout issues
    [DownlinkSpecPacsat.csv, DownlinkSpecPacsat.xlsx]
2026-04-15 Updated pacsat layouts
    [PACSAT_errtelemetry.csv, PACSAT_errwodtelemetry.csv, PACSAT_rttelemetry.csv, PACSAT_wodtelemetry.csv]
2026-04-15 Fix ERRWOD layout
    [PACSAT_errwodtelemetry.csv]
2026-04-21 Add board voltages and power flags to telem
    [DownlinkSpecPacsat.csv, DownlinkSpecPacsat.xlsx]
2026-04-21 Fix formatting of board voltages
    [DownlinkSpecPacsat.csv, DownlinkSpecPacsat.xlsx]
2026-04-21 Fix bit layout for power flags
    [DownlinkSpecPacsat.csv, DownlinkSpecPacsat.xlsx]
2026-04-27 Latest ground station layouts updated
    [PACSAT_errwodtelemetry.csv, PACSAT_rttelemetry.csv, PACSAT_wodtelemetry.csv]
2026-04-28 Updated for minmax calcs and added autosave thresholds
    [DownlinkSpecPacsat.csv, DownlinkSpecPacsat.xlsx]
2026-04-29 Update ground station telem for min max
    [DownlinkSpecPacsat.csv, DownlinkSpecPacsat.xlsx, PACSAT_maxtelemetry.csv, PACSAT_mintelemetry.csv, PACSAT_rttelemetry.csv, PACSAT_wodtelemetry.csv]
